TJ71PL/Precision-Clock/electronics/3d/HDC1080DMBR.STEP

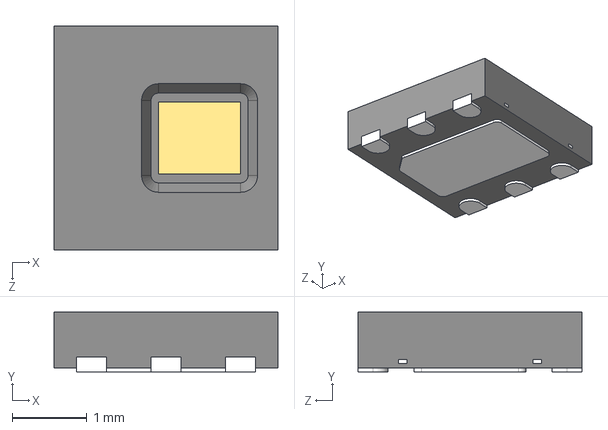
[picture p1: CAD file, 2026-03-11]
electronics/3d/HDC1080DMBR.STEP
3.00 x 0.8 x 3.00 mm
