TJ71PL/Precision-Clock/electronics/3d/WSON-8(8mm x 6mm).step

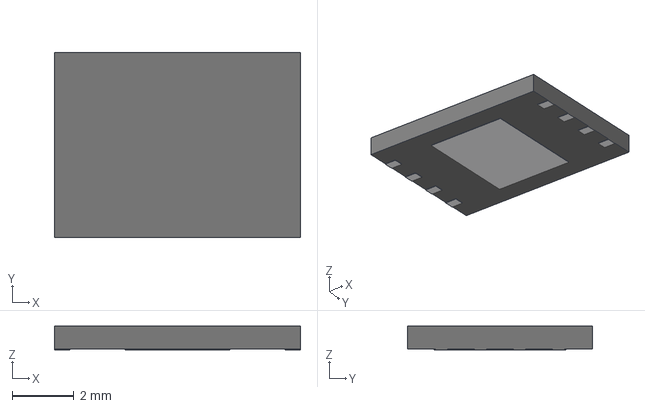
[picture p2: CAD file, 2026-03-08]
electronics/3d/WSON-8(8mm x 6mm).step
8.00 x 6.00 x 0.77 mm
