TJ71PL/Precision-Clock/electronics/3d/SA15-11SURKWA.stp

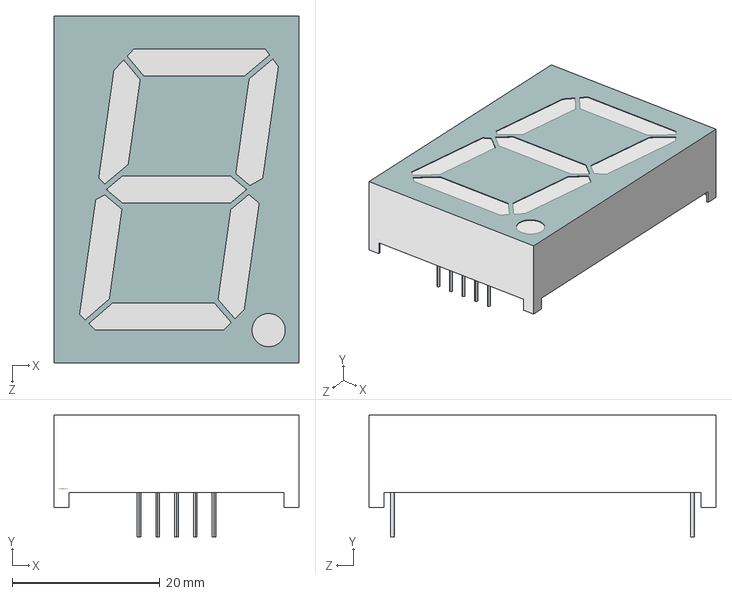
[picture p3: CAD file, 2026-03-08]
electronics/3d/SA15-11SURKWA.stp
33.2 x 16.5 x 47.0 mm
