TJ71PL/Precision-Clock/electronics/3d/PEC09-2320F-T0015.step

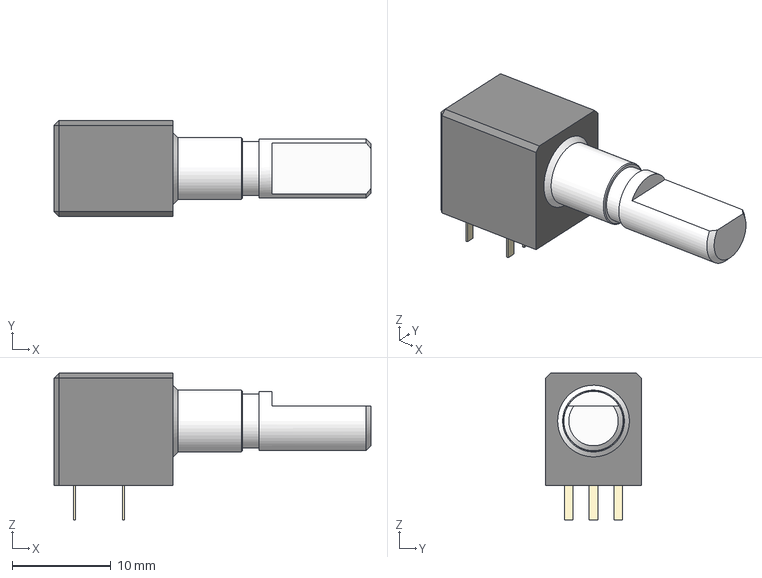
[picture p4: CAD file, 2026-02-25]
electronics/3d/PEC09-2320F-T0015.step
32.0 x 9.70 x 14.8 mm
