TJ71PL/Precision-Clock/electronics/3d/ST0201.step

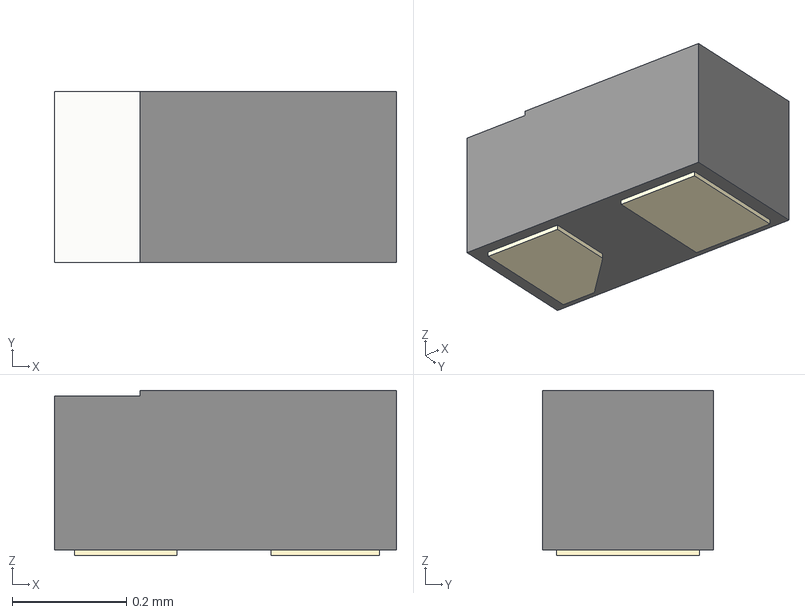
[picture p5: CAD file, 2026-02-25]
electronics/3d/ST0201.step
0.6 x 0.3 x 0.29 mm
