TJ71PL/Precision-Clock/electronics/3d/PinHeader_2x07_P1.27mm_Vertical_SMD.step

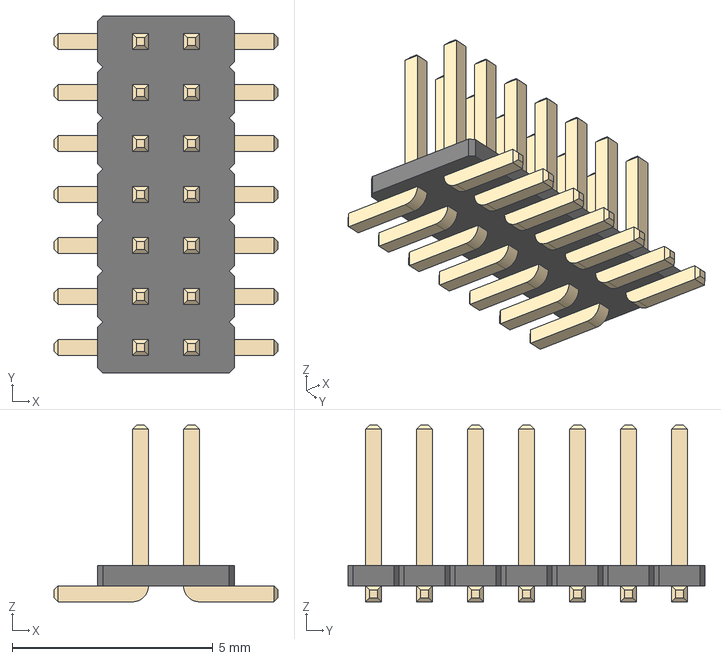
[picture p6: CAD file, 2026-02-24]
electronics/3d/PinHeader_2x07_P1.27mm_Vertical_SMD.step
5.57 x 8.89 x 4.40 mm
