TJ71PL/Precision-Clock/electronics/3d/SMA_Molex_73251-1153_EdgeMount_Horizontal.step

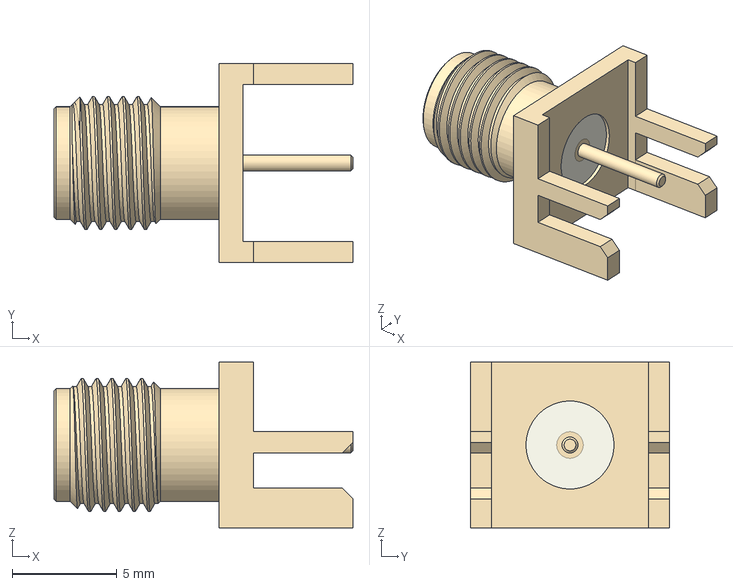
[picture p7: CAD file, 2026-02-24]
electronics/3d/SMA_Molex_73251-1153_EdgeMount_Horizontal.step
14.3 x 9.52 x 7.92 mm
