TJ71PL/Precision-Clock/electronics/3d/TEPT5700.STEP

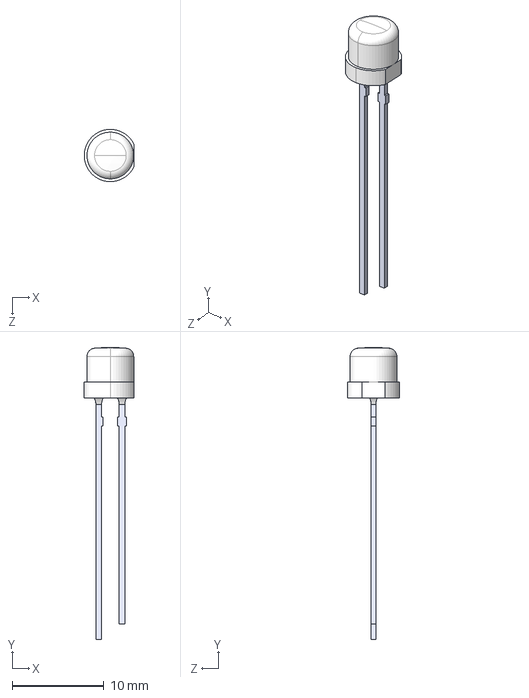
[picture p8: CAD file, 2026-02-24]
electronics/3d/TEPT5700.STEP
5.40 x 31.9 x 5.70 mm
