TJ71PL/Precision-Clock/electronics/3d/PWP0024B.stp

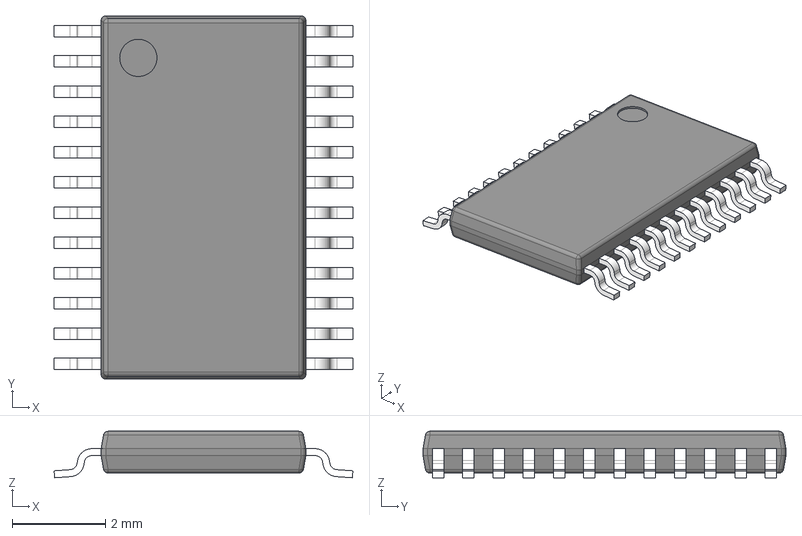
[picture p9: CAD file, 2026-02-09]
electronics/3d/PWP0024B.stp
6.42 x 7.80 x 1.00 mm
BODY-SO
LEAD-SO x 24
THERMALPAD-SO
PIN1-ID
