TJ71PL/Precision-Clock/electronics/3d/MC-146.stp

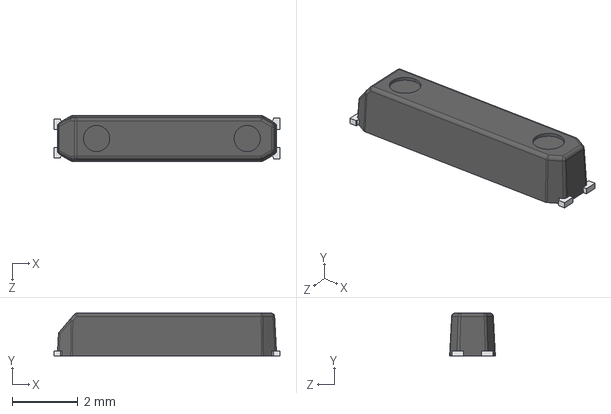
[picture p10: CAD file, 2026-02-09]
electronics/3d/MC-146.stp
6.90 x 1.30 x 1.40 mm
