TJ71PL/Precision-Clock/electronics/3d/PS1740P02CE.stp

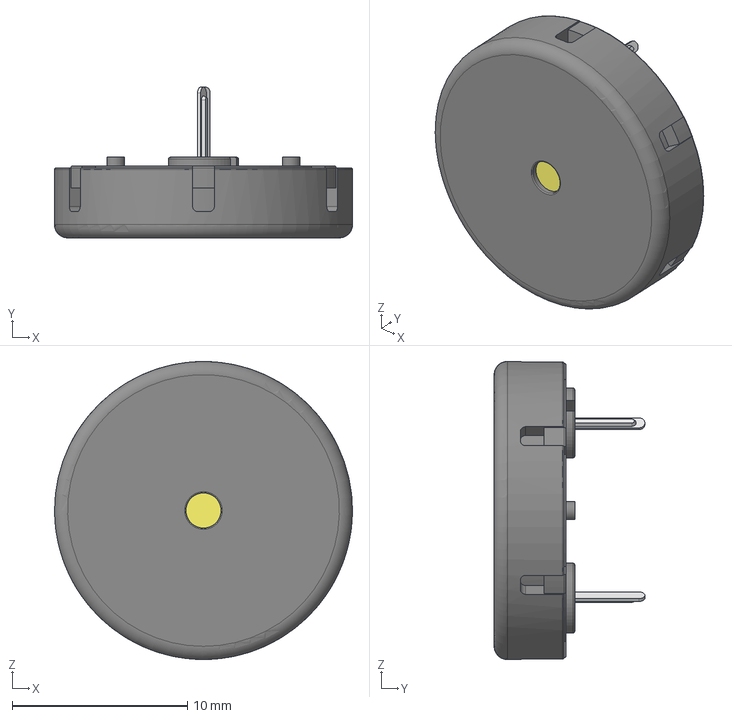
[picture p11: CAD file, 2026-01-29]
electronics/3d/PS1740P02CE.stp
17.0 x 8.60 x 17.0 mm
