TJ71PL/Precision-Clock/electronics/3d/SSSS811101.STEP

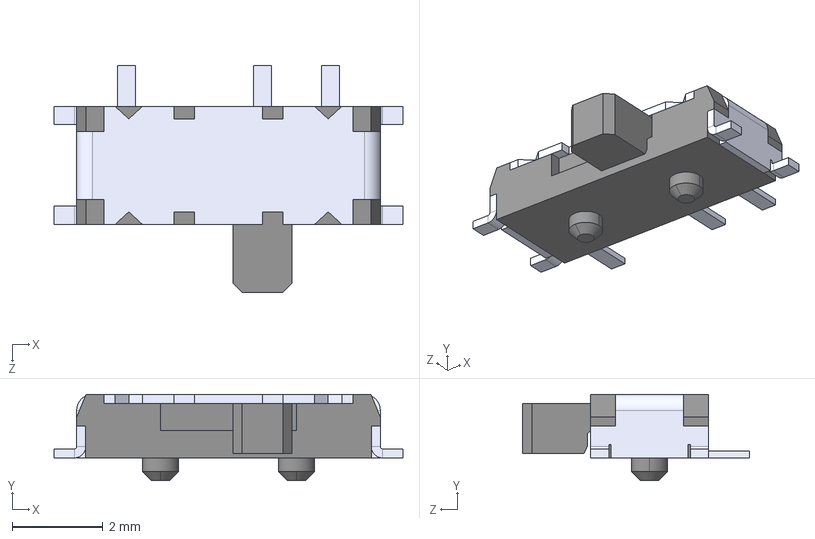
[picture p12: CAD file, 2026-01-27]
electronics/3d/SSSS811101.STEP
7.70 x 1.90 x 5.00 mm
