TJ71PL/Precision-Clock/electronics/3d/1060.STEP

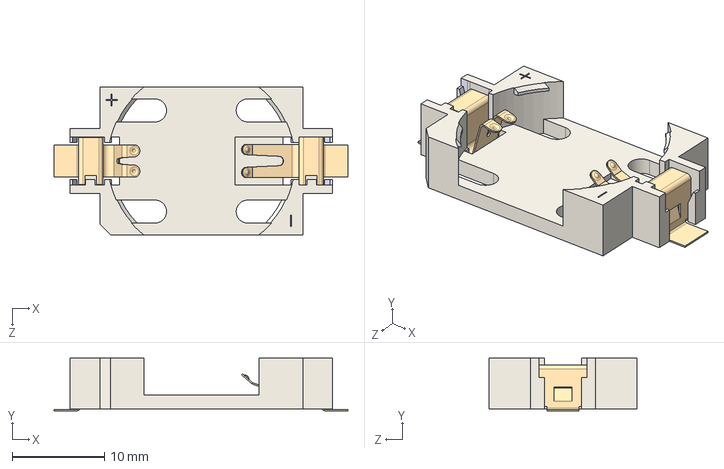
[picture p13: CAD file, 2025-11-13]
electronics/3d/1060.STEP
31.8 x 5.69 x 16.0 mm
