TJ71PL/Precision-Clock/electronics/3d/MAX-M10S-00B.STEP

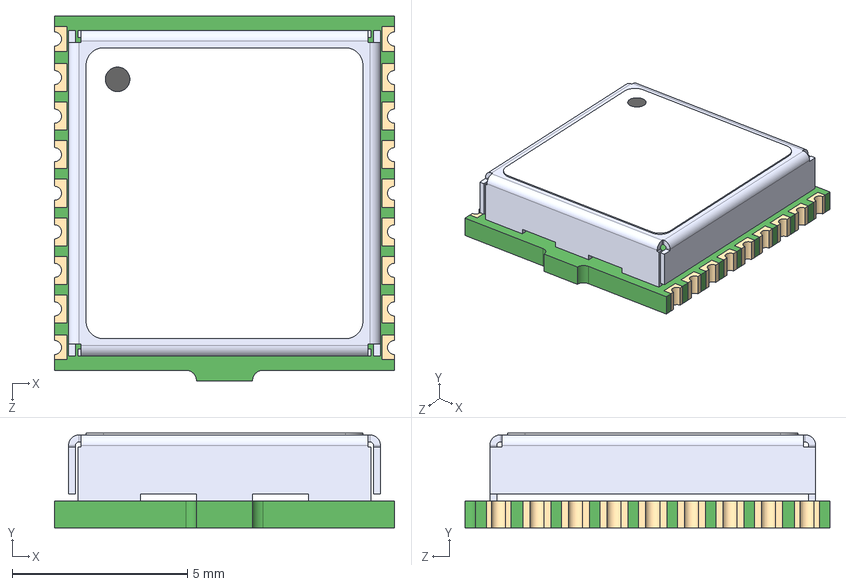
[picture p14: CAD file, 2025-10-22]
electronics/3d/MAX-M10S-00B.STEP
9.70 x 2.70 x 10.4 mm
