TJ71PL/Precision-Clock/electronics/3d/AP33771C.stp

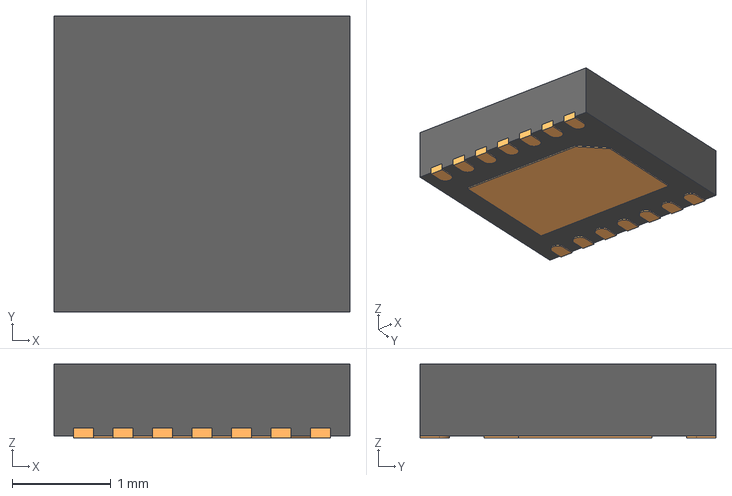
[picture p15: CAD file, 2026-02-24]
electronics/3d/AP33771C.stp
3.00 x 3.00 x 0.75 mm
