TJ71PL/Precision-Clock/electronics/3d/1054500101.stp

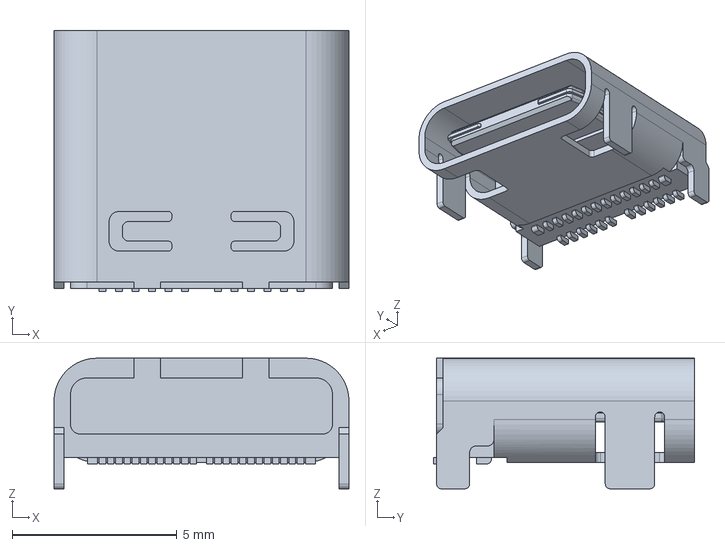
[picture p16: CAD file, 2025-11-11]
electronics/3d/1054500101.stp
8.94 x 7.90 x 3.96 mm
