TJ71PL/Precision-Clock/electronics/Schematic.pdf

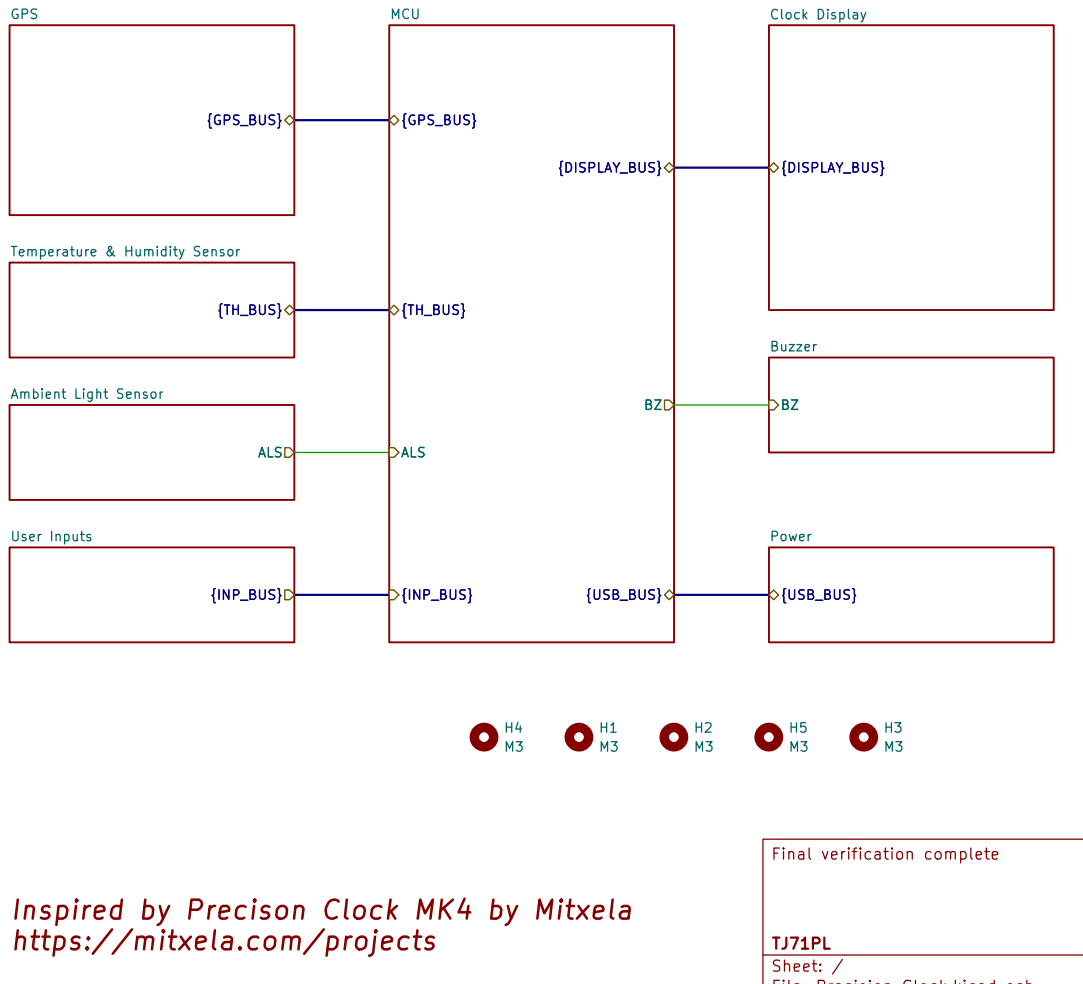
[picture p17: page 1]

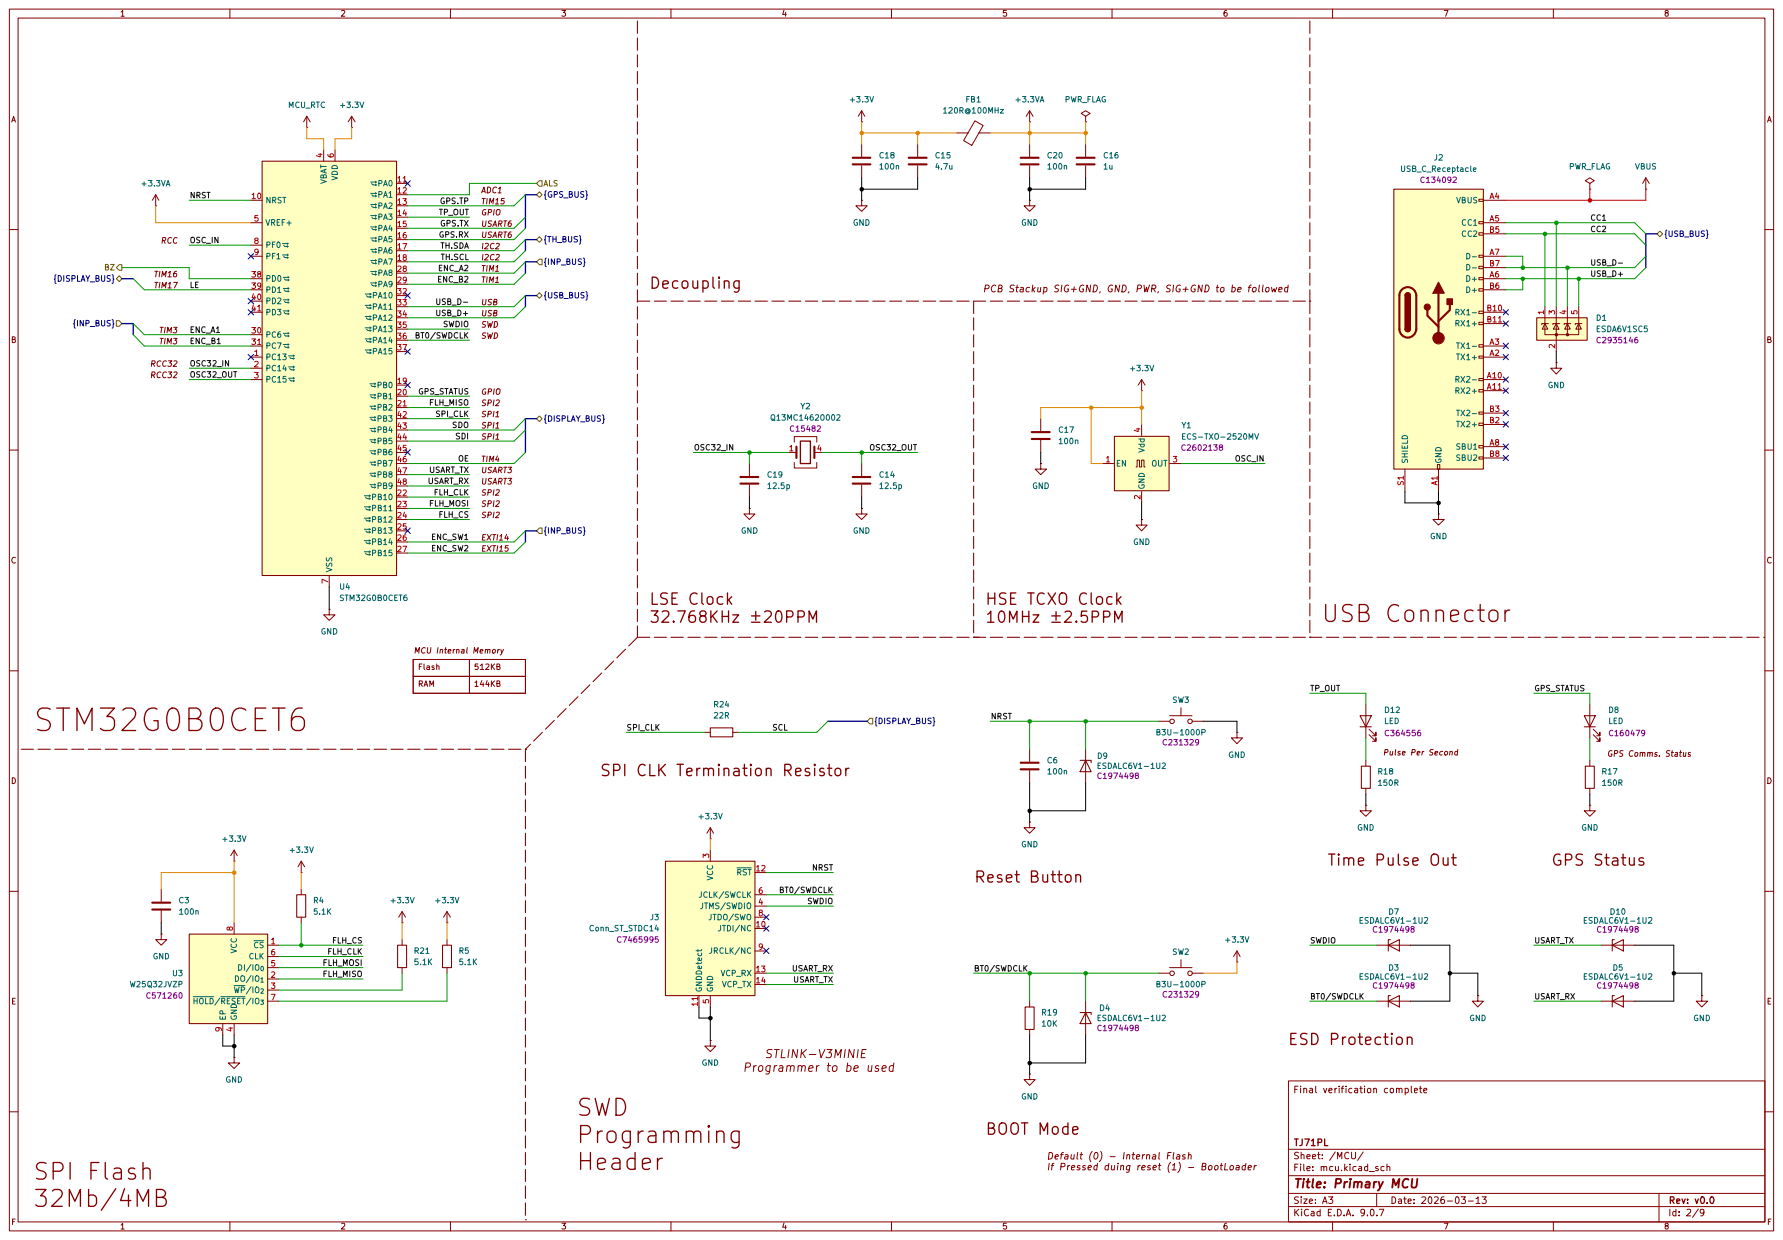
[picture p18: page 2]

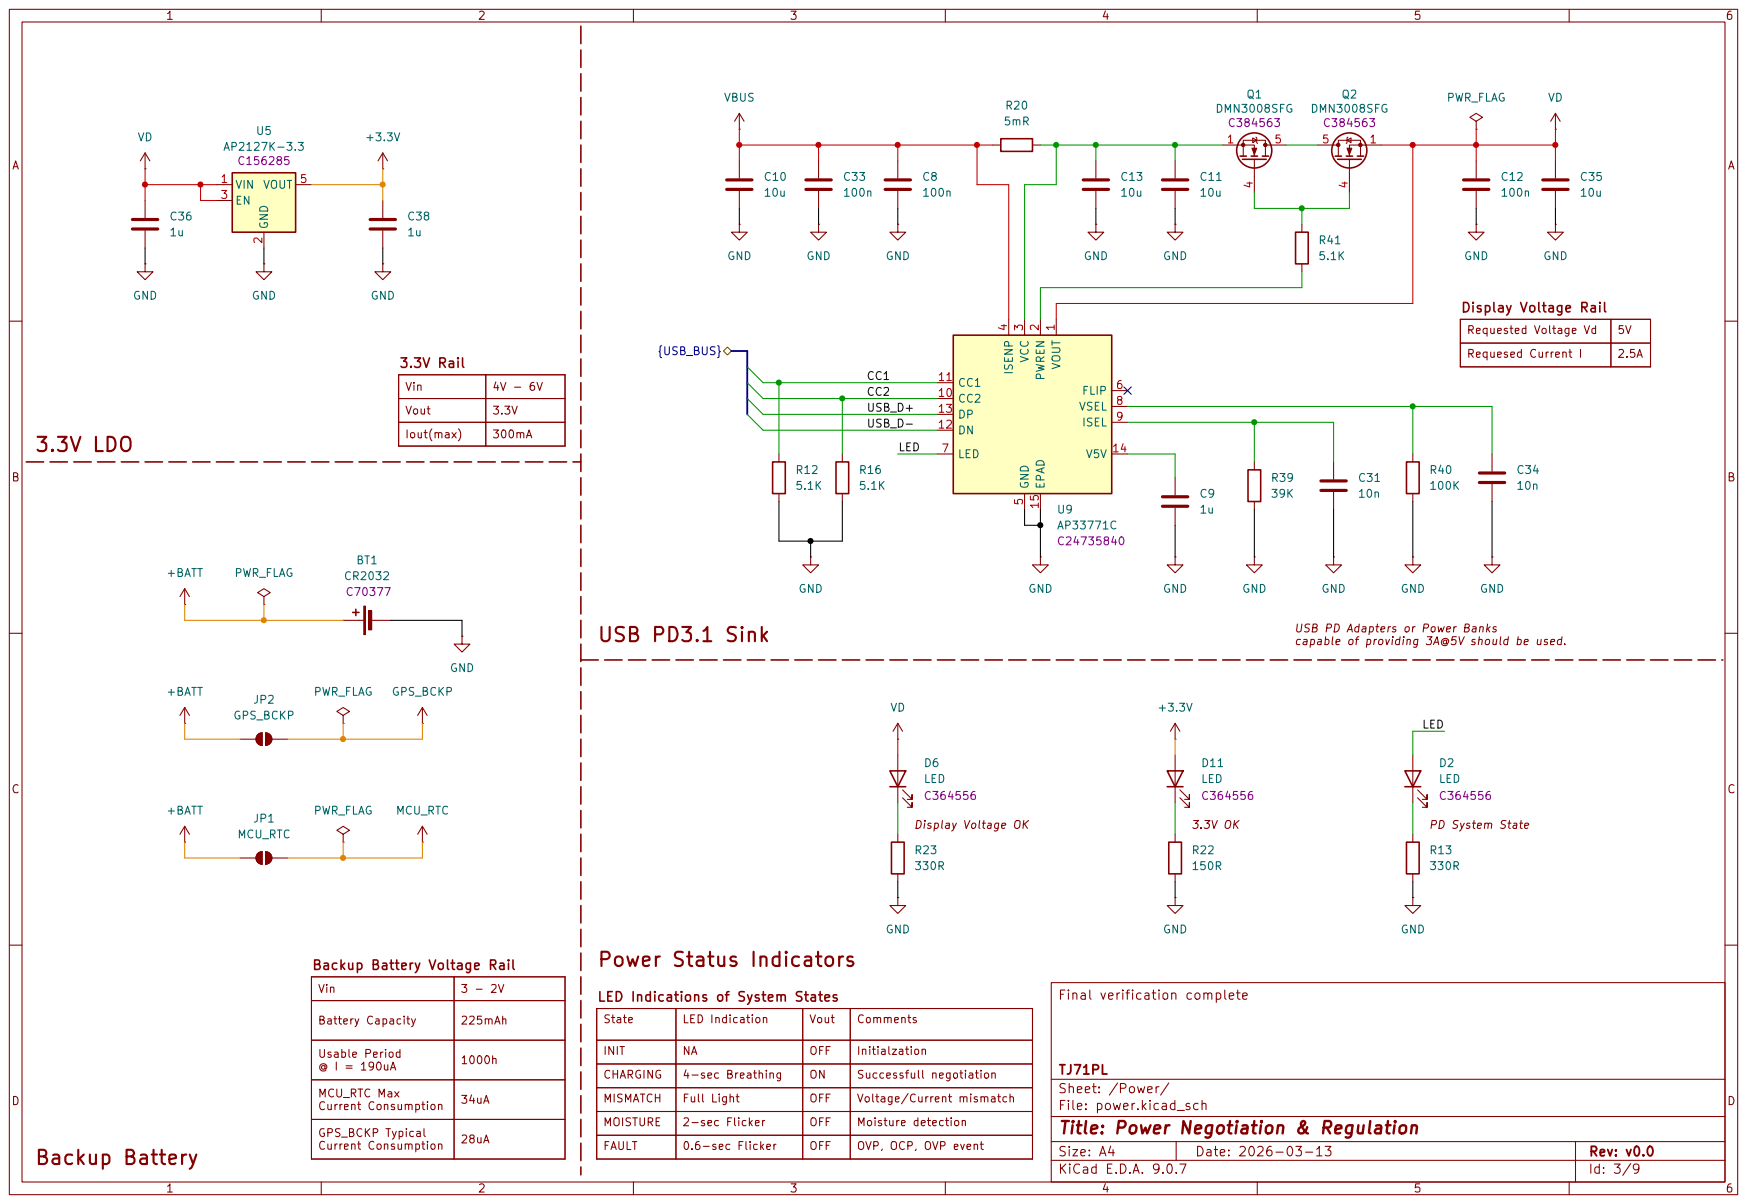
[picture p19: page 3]

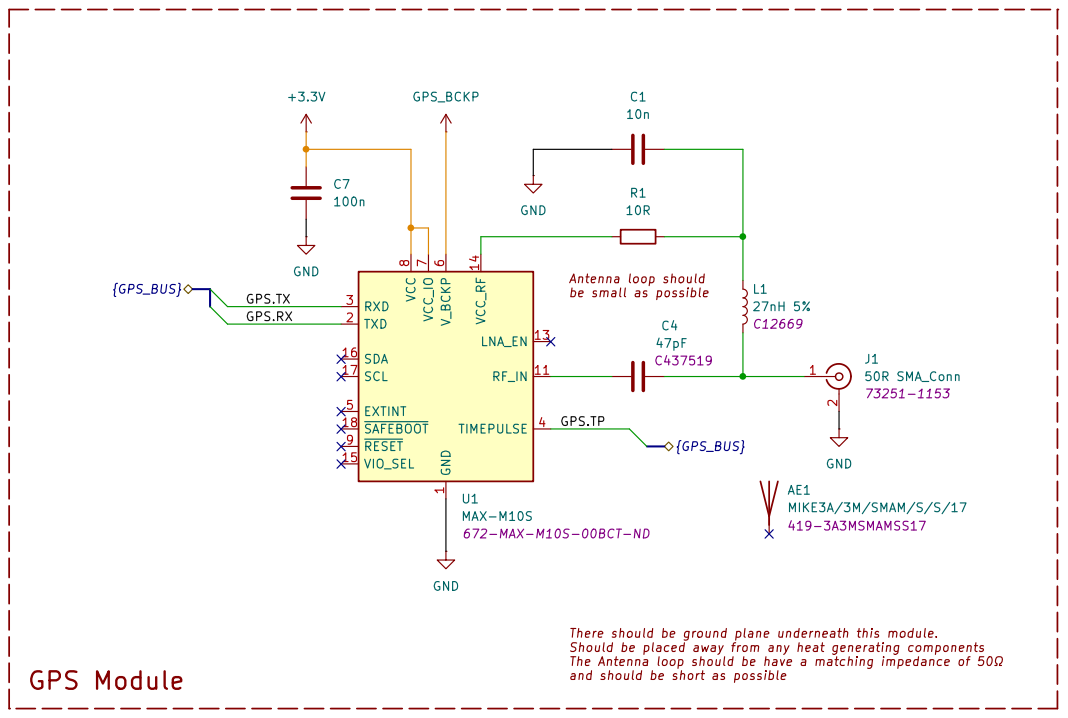
[picture p20: page 4]

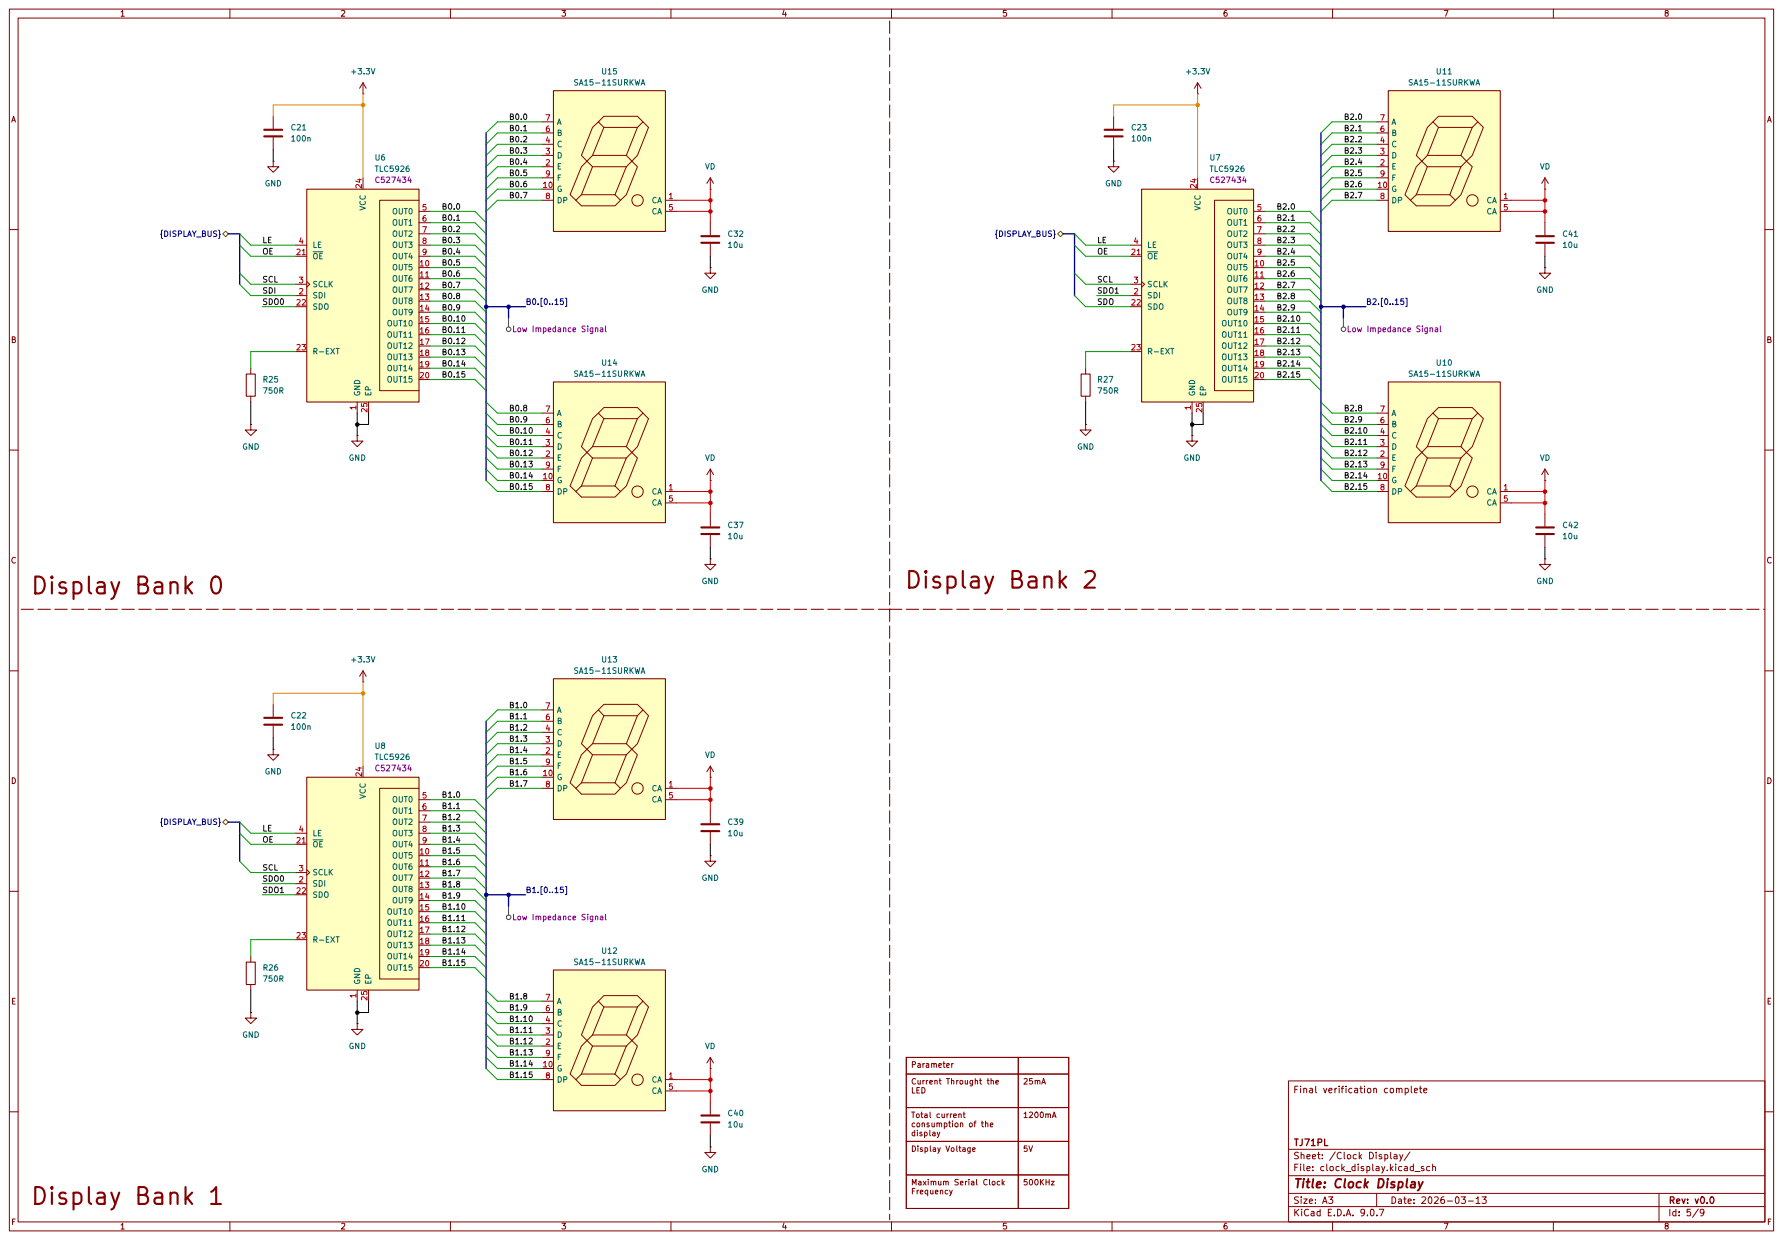
[picture p21: page 5]

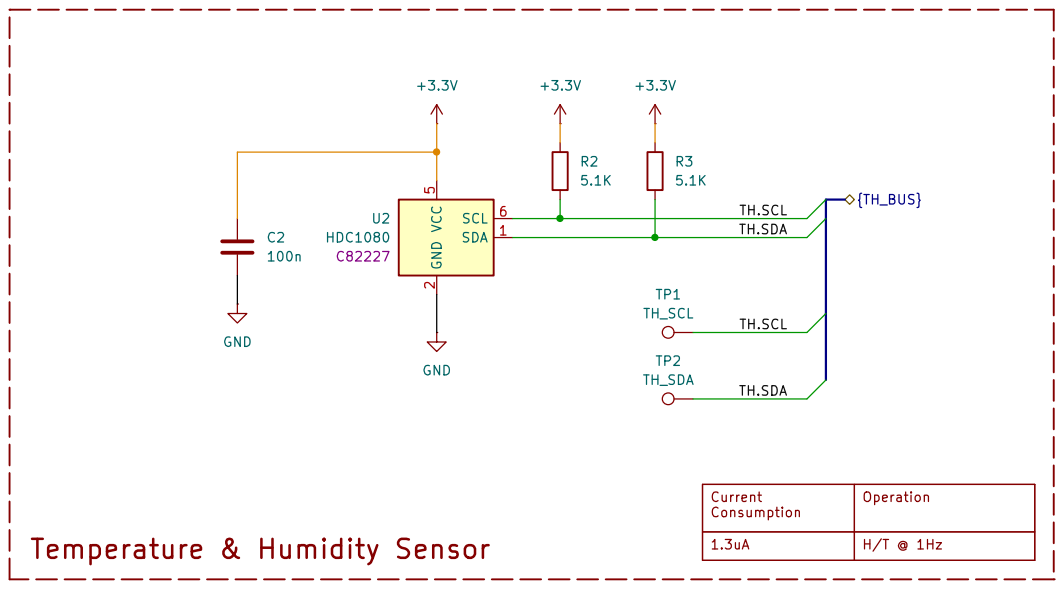
[picture p22: page 6]

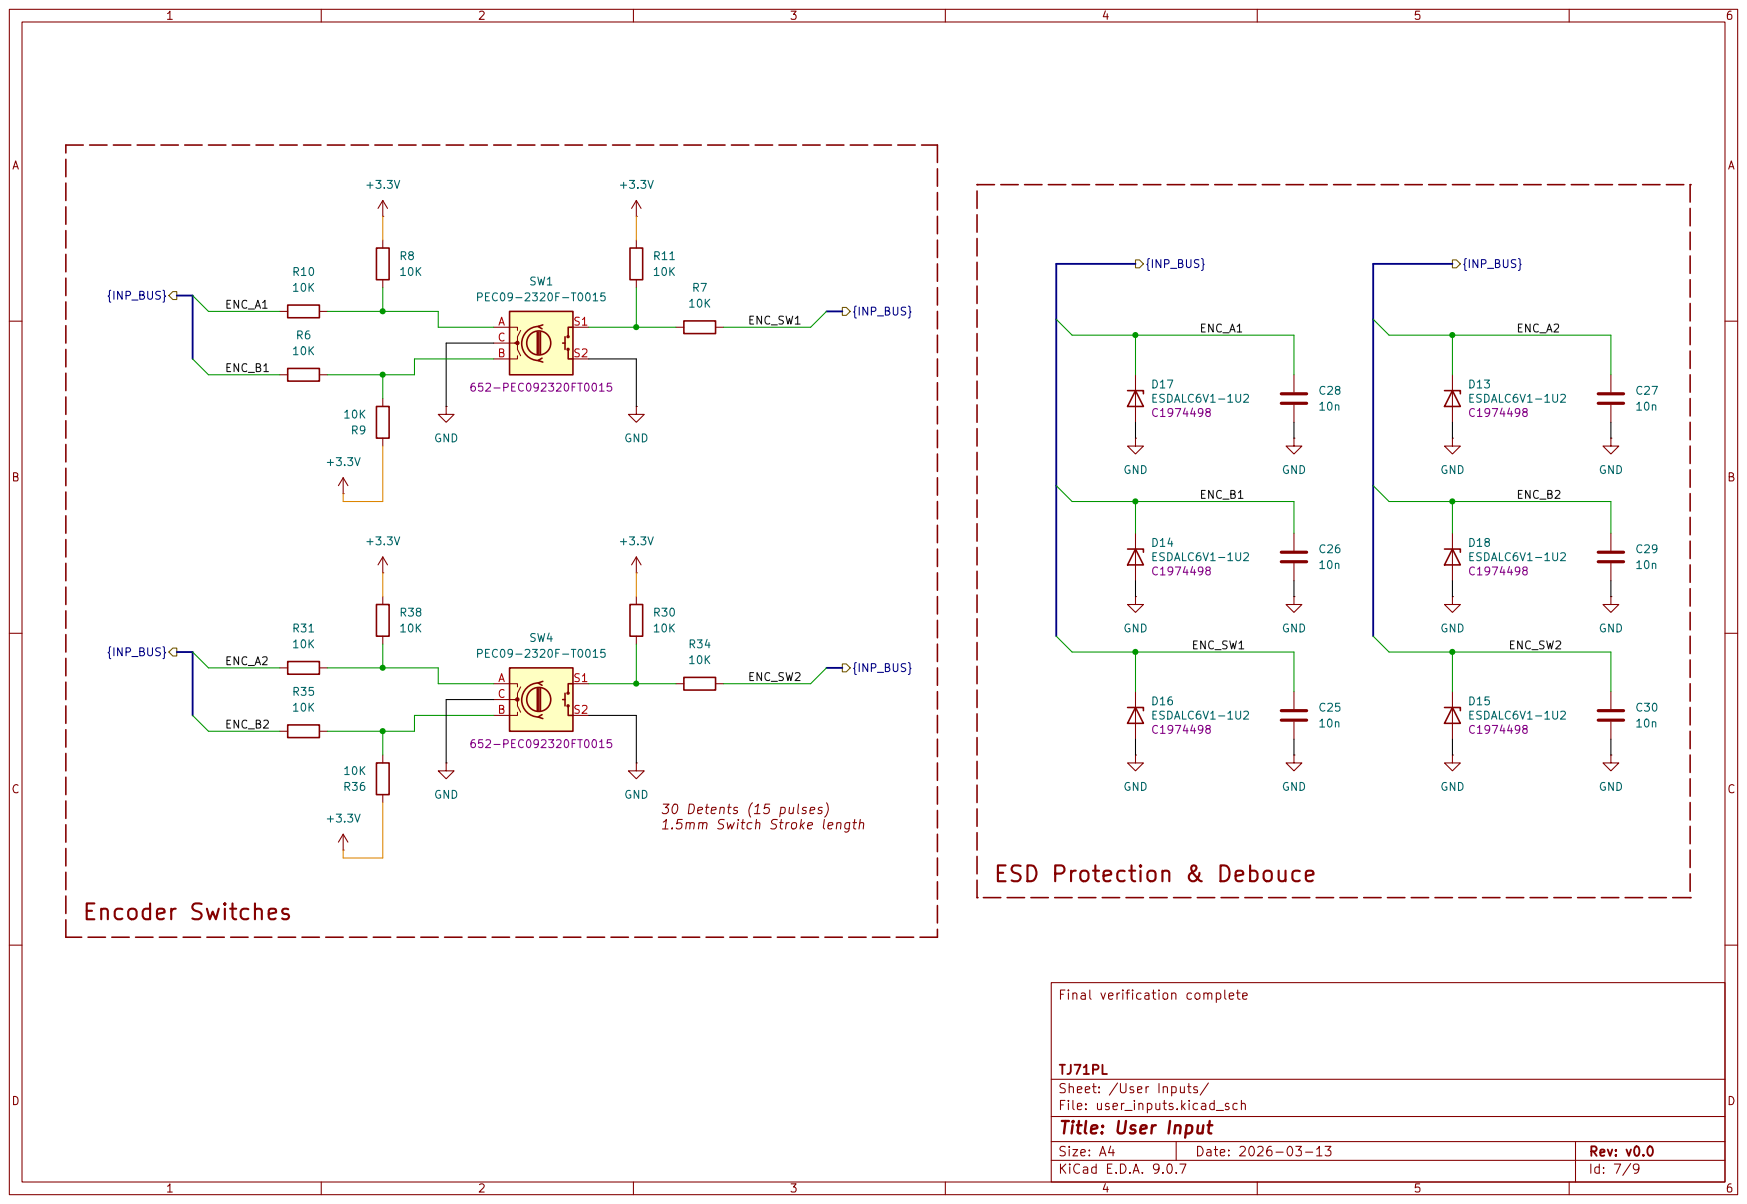
[picture p23: page 7]

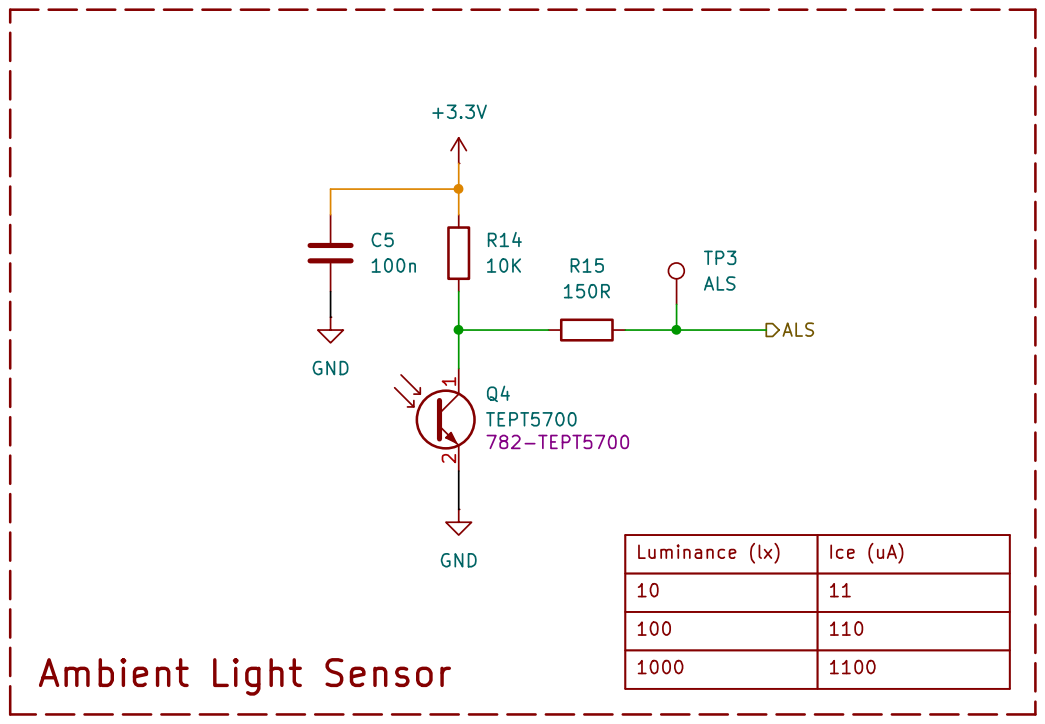
[picture p24: page 8]

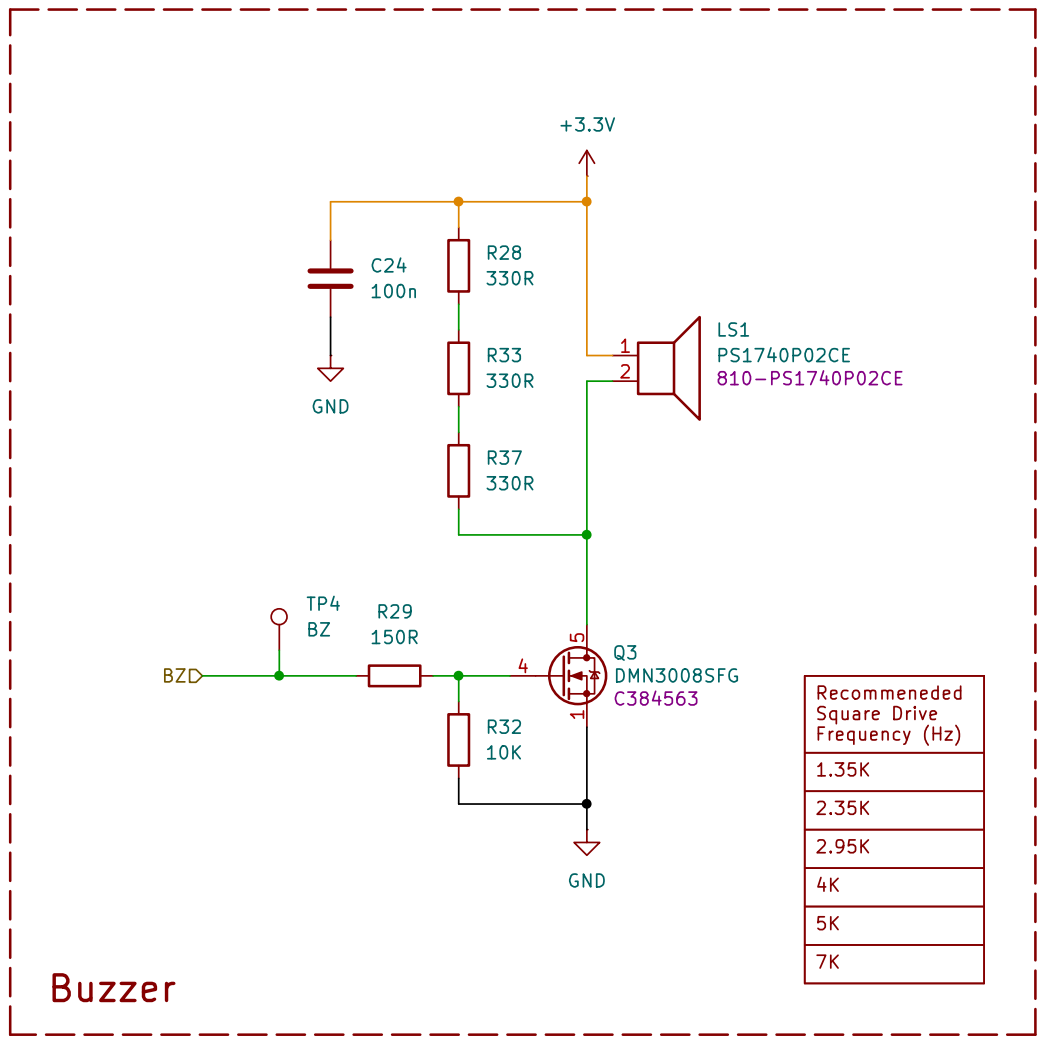
[picture p25: page 9]
