TJ71PL/Precision-Clock/electronics/Precision Clock.kicad_pcb

## KiCad design electronics/Precision Clock.kicad_pcb (2026-06-09)

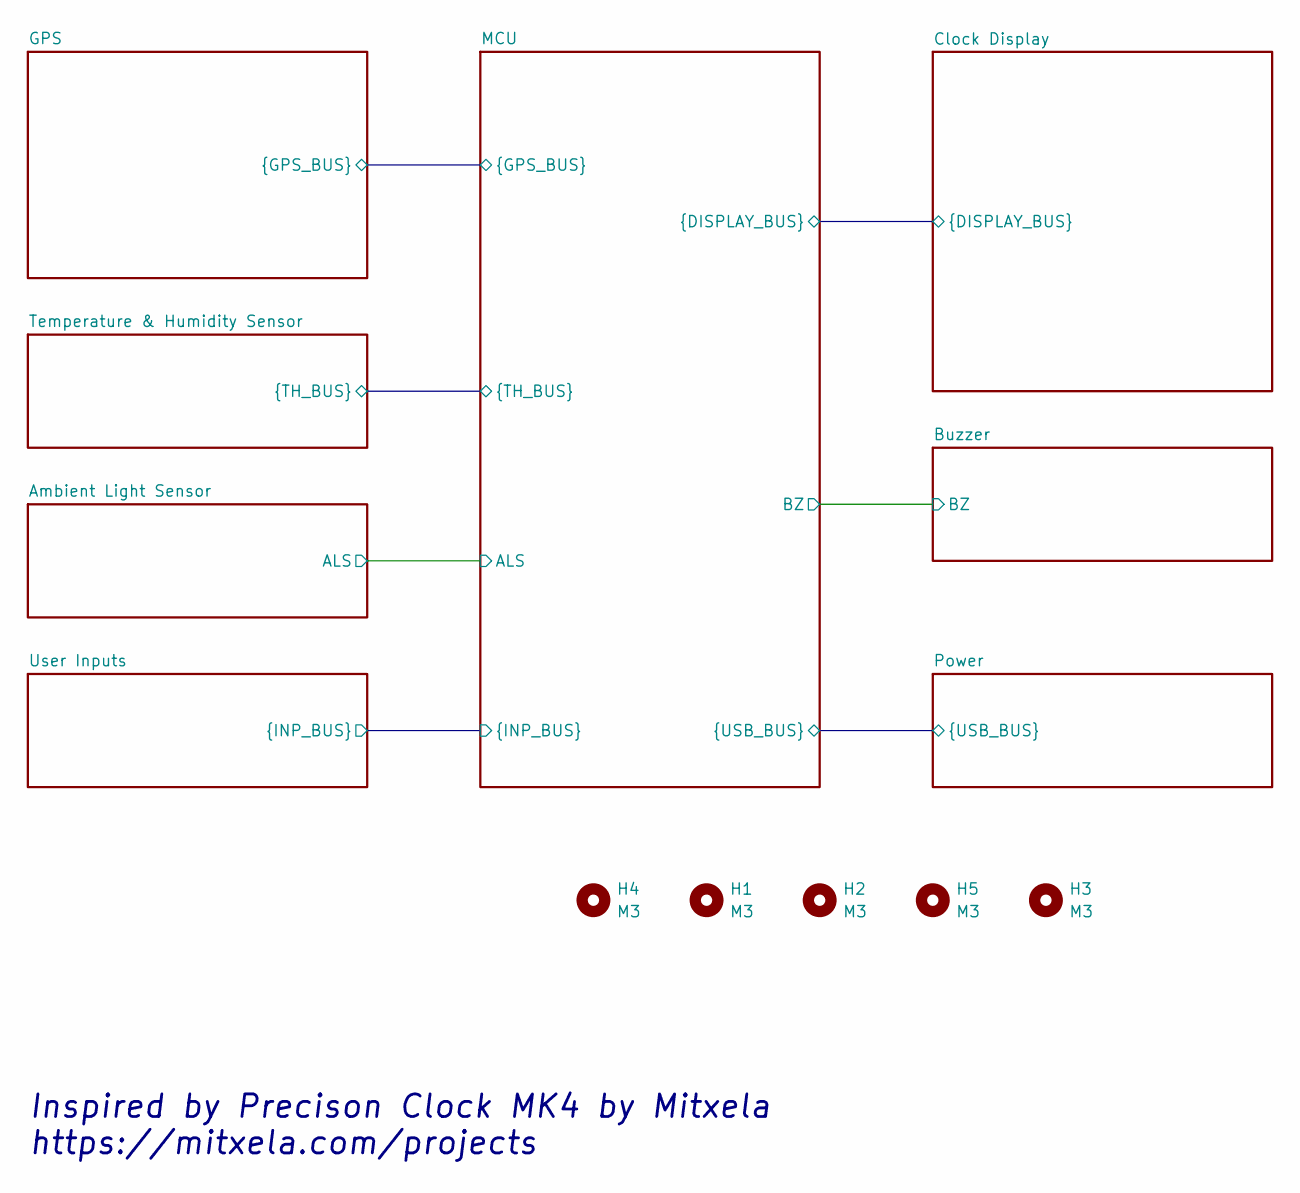
[picture p35: schematic Precision Clock.kicad_sch, Precision Clock]

Parts:
H1, H2, H3, H4, H5: M3; MountingHole_3.2mm_M3

Notes on the sheet:
Inspired by Precison Clock MK4 by Mitxela https://mitxela.com/projects

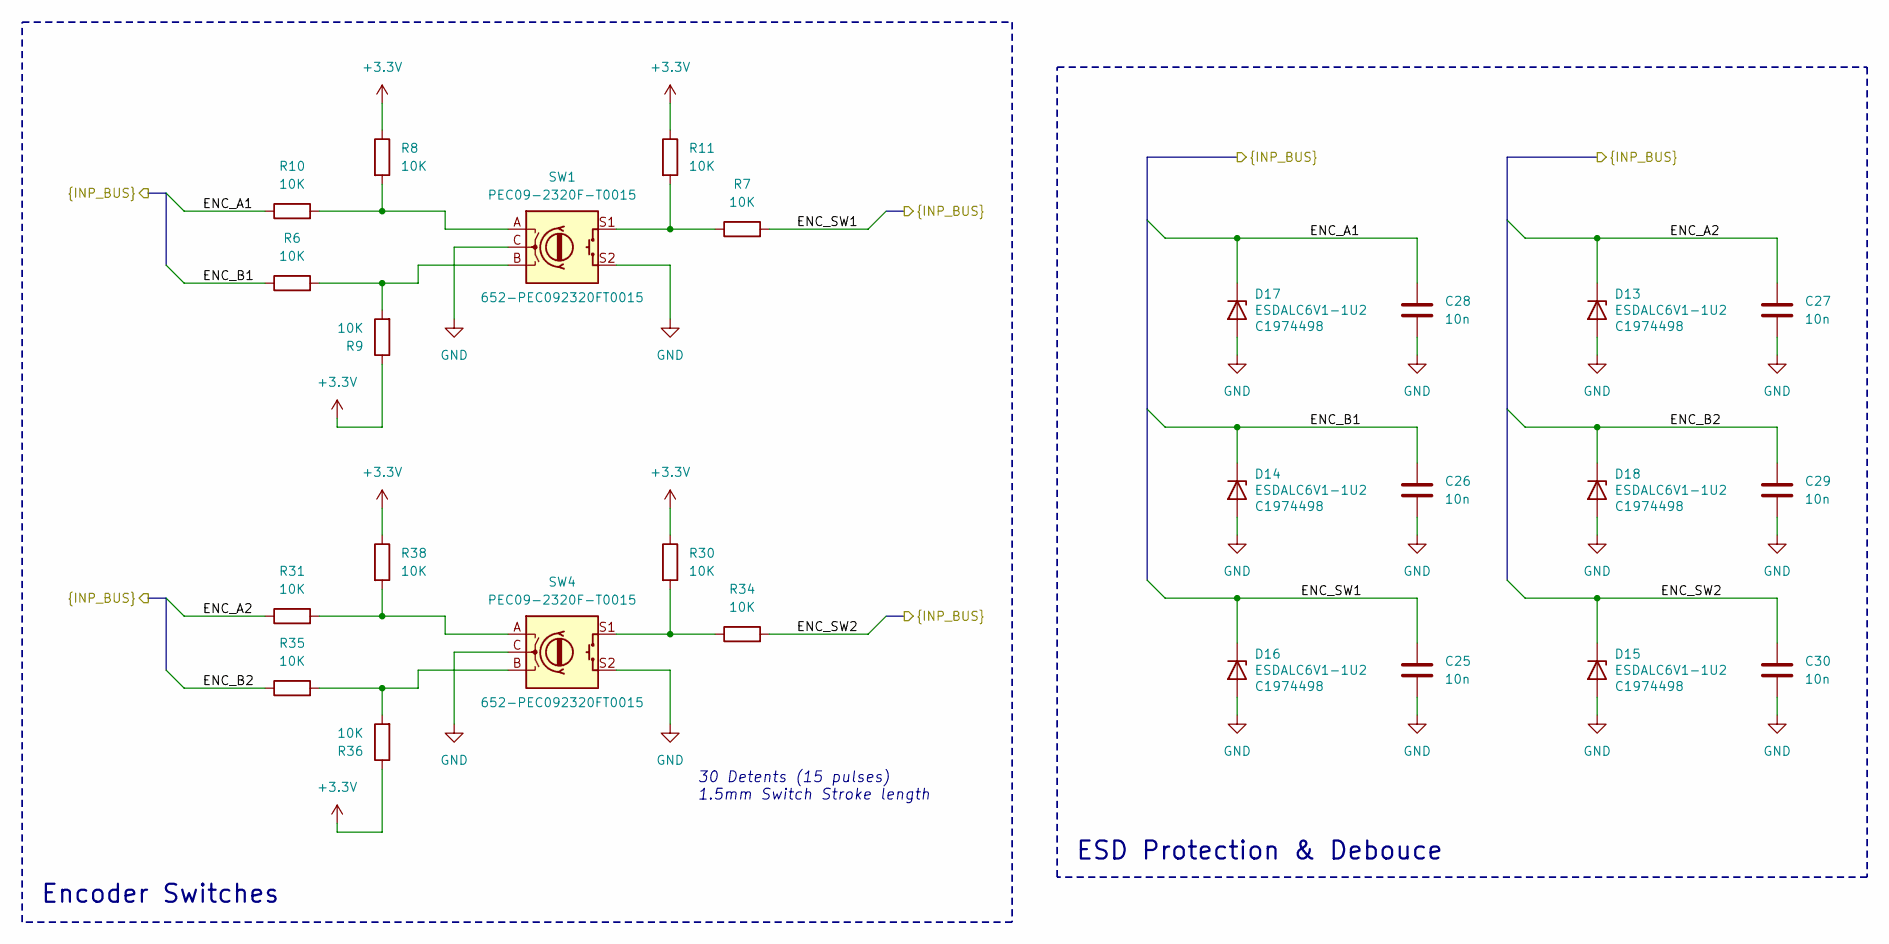
[picture p36: schematic user_inputs.kicad_sch, User Input]

Parts:
C25, C26, C27, C28, C29, C30: 10n; C_0402_1005Metric; LCSC C15195
D13, D14, D15, D16, D17, D18: ESDALC6V1-1U2; ST ESDALC6V1-1U2; LCSC C1974498
R6, R7, R8, R9, R10, R11, R30, R31, R34, R35, R36, R38: 10K; R_0402_1005Metric; LCSC C60489
SW1, SW4: PEC09-2320F-T0015; RotaryEncoder_Bourns_Horizontal_PEC09-2xxxF-Txxxx; Mouser 652-PEC092320FT0015

Connections:
+3.3V: R8.1, R9.1, R11.1, R30.1, R36.1, R38.1; also elsewhere on the board
/MCU/ENC_A1: C28.1, D17.1 (K), R10.1; also elsewhere on the board
/MCU/ENC_A2: C27.1, D13.1 (K), R31.1; also elsewhere on the board
/MCU/ENC_B1: C26.1, D14.1 (K), R6.1; also elsewhere on the board
/MCU/ENC_B2: C29.1, D18.1 (K), R35.1; also elsewhere on the board
/MCU/ENC_SW1: C25.1, D16.1 (K), R7.2; also elsewhere on the board
/MCU/ENC_SW2: C30.1, D15.1 (K), R34.2; also elsewhere on the board
GND: C25.2, C26.2, C27.2, C28.2, C29.2, C30.2, D13.2 (A), D14.2 (A), D15.2 (A), D16.2 (A), D17.2 (A), D18.2 (A), SW1.C, SW1.S2, SW4.C, SW4.S2; also elsewhere on the board
unnamed: R6.2, R9.2, SW1.B
unnamed: R8.2, R10.2, SW1.A
unnamed: R7.1, R11.2, SW1.S1
unnamed: R30.2, R34.1, SW4.S1
unnamed: R31.2, R38.2, SW4.A
unnamed: R35.2, R36.2, SW4.B

Notes on the sheet:
Encoder Switches
ESD Protection & Debouce
30 Detents (15 pulses) 1.5mm Switch Stroke length

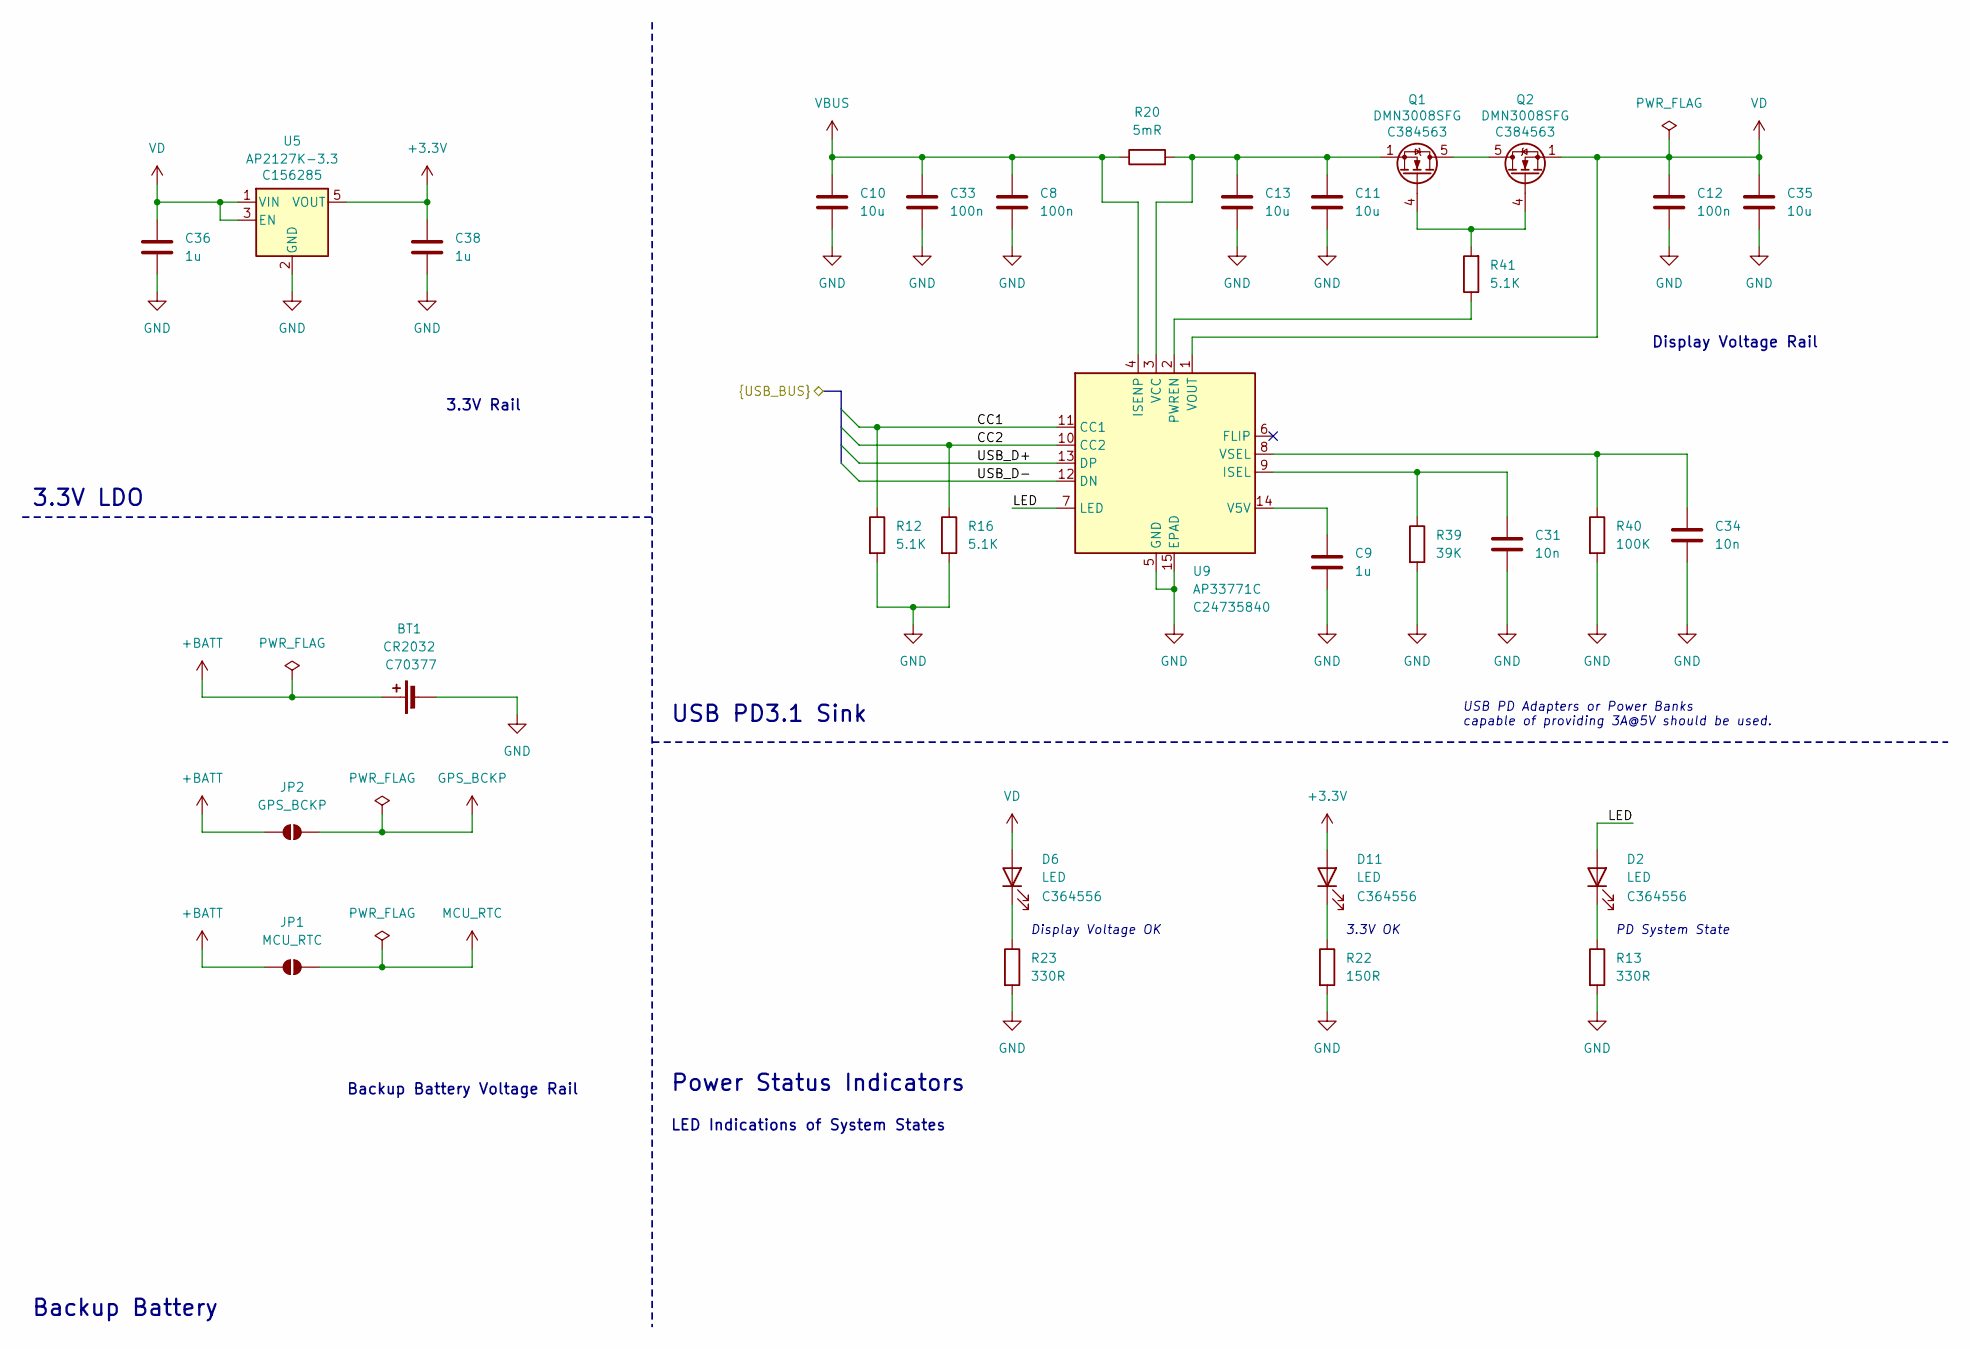
[picture p37: schematic power.kicad_sch, Power Negotiation & Regulation]

Parts:
BT1: CR2032; Battery_holder_CR2032_SMD; LCSC C70377
C8, C12, C33: 100n; C_0402_1005Metric; LCSC C1525
C9, C36, C38: 1u; C_0402_1005Metric; LCSC C29266
C10, C11, C13, C35: 10u; C_0603_1608Metric; LCSC C86275
C31, C34: 10n; C_0402_1005Metric; LCSC C15195
D2, D6, D11: LED; LED_LiteON_LTST-C281KGKT; LCSC C364556
JP1: MCU_RTC; SolderJumper-2_P1.3mm_Open_TrianglePad1.0x1.5mm
JP2: GPS_BCKP; SolderJumper-2_P1.3mm_Open_TrianglePad1.0x1.5mm
Q1, Q2: DMN3008SFG; Diodes_PowerDI3333-8; LCSC C384563
R12, R16, R41: 5.1K; R_0402_1005Metric; LCSC C105872
R13, R23: 330R; R_0402_1005Metric; LCSC C276273
R20: 5mR; R_0805_2012Metric; LCSC C92742
R22: 150R; R_0402_1005Metric; LCSC C276273
R39: 39K; R_0402_1005Metric; LCSC C137995
R40: 100K; R_0402_1005Metric; LCSC C60491
U5: AP2127K-3.3; SOT-23-5; LCSC C156285
U9: AP33771C; W-DFN3030-14 (Type A1) Diodes; LCSC C24735840

Connections:
+3.3V: C38.1, D11.2 (A), U5.5 (VOUT); also elsewhere on the board
+BATT: BT1.1 (+), JP1.1 (A), JP2.1 (A)
/MCU/CC1: R12.1, U9.11 (CC1); also elsewhere on the board
/MCU/CC2: R16.1, U9.10 (CC2); also elsewhere on the board
/MCU/USB_D+: U9.13 (DP); also elsewhere on the board
/MCU/USB_D-: U9.12 (DN); also elsewhere on the board
/Power/LED: D2.2 (A), U9.7 (LED)
GND: BT1.2 (-), C8.2, C9.2, C10.2, C11.2, C12.2, C13.2, C31.2, C33.2, C34.2, C35.2, C36.2, C38.2, R12.2, R13.2, R16.2, R22.2, R23.2, R39.2, R40.2, U5.2 (GND), U9.5 (GND), U9.15 (EPAD); also elsewhere on the board
GPS_BCKP: JP2.2 (B); also elsewhere on the board
MCU_RTC: JP1.2 (B); also elsewhere on the board
unnamed: D2.1 (K), R13.1
unnamed: D6.1 (K), R23.1
unnamed: D11.1 (K), R22.1
unnamed: Q1.5 (D), Q2.5 (D)
unnamed: Q1.4 (G), Q2.4 (G), R41.2
unnamed: C31.1, R39.1, U9.9 (ISEL)
unnamed: R41.1, U9.2 (PWREN)
unnamed: C9.1, U9.14 (V5V)
unnamed: C11.1, C13.1, Q1.1 (S), Q1.2 (S), Q1.3 (S), R20.2, U9.3 (VCC)
unnamed: C34.1, R40.1, U9.8 (VSEL)
VBUS: C8.1, C10.1, C33.1, R20.1, U9.4 (ISENP); also elsewhere on the board
VD: C12.1, C35.1, C36.1, D6.2 (A), Q2.1 (S), Q2.2 (S), Q2.3 (S), U5.1 (VIN), U5.3 (EN), U9.1 (VOUT); also elsewhere on the board

Notes on the sheet:
LED Indications of System States
Backup Battery
3.3V LDO
USB PD Adapters or Power Banks capable of providing 3A@5V should be used.
3.3V OK
PD System State
Display Voltage OK
Display Voltage Rail
3.3V Rail
Backup Battery Voltage Rail
Power Status Indicators
USB PD3.1 Sink

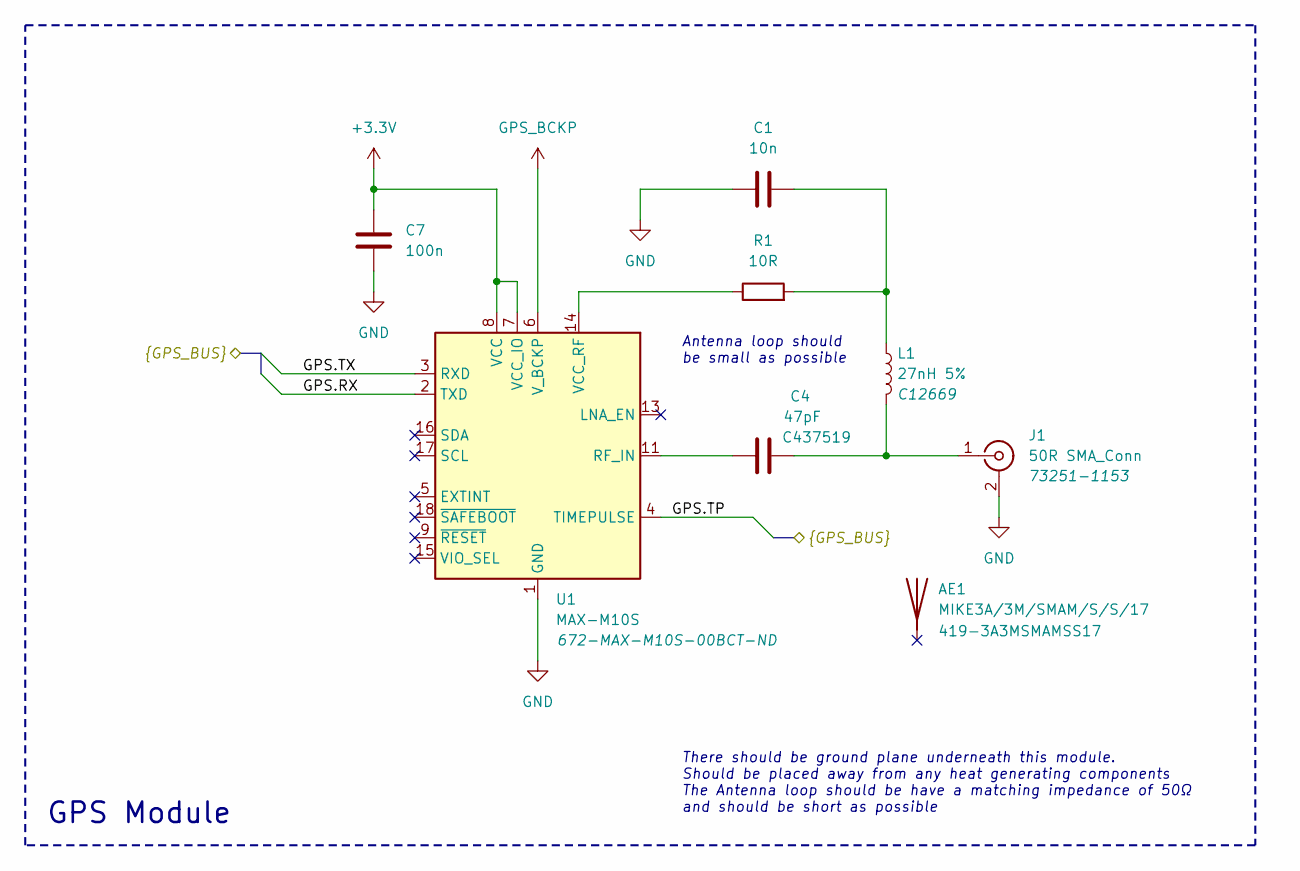
[picture p38: schematic gps.kicad_sch, GPS Module]

Parts:
AE1: MIKE3A/3M/SMAM/S/S/17; Mouser 419-3A3MSMAMSS17
C1: 10n; C_0402_1005Metric; LCSC C15195
C4: 47pF; C_0402_1005Metric; LCSC C437519
C7: 100n; C_0402_1005Metric; LCSC C1525
J1: 50R SMA_Conn; SMA_Molex_73251-1153_EdgeMount_Horizontal; Mouser 73251-1153
L1: 27nH 5%; L_0402_1005Metric; LCSC C12669
R1: 10R; R_0603_1608Metric; LCSC C109318
U1: MAX-M10S; ublox_MAX; Digikey 672-MAX-M10S-00BCT-ND

Connections:
+3.3V: C7.1, U1.7 (VCC_IO), U1.8 (VCC); also elsewhere on the board
/GPS/GPS.RX: U1.2 (TXD); also elsewhere on the board
/GPS/GPS.TP: U1.4 (TIMEPULSE); also elsewhere on the board
/GPS/GPS.TX: U1.3 (RXD); also elsewhere on the board
GND: C1.1, C7.2, J1.2 (Ext), U1.1 (GND), U1.10 (GND), U1.12 (GND); also elsewhere on the board
GPS_BCKP: U1.6 (V_BCKP); also elsewhere on the board
unnamed: C1.2, L1.1, R1.2
unnamed: C4.2, J1.1 (In), L1.2
unnamed: C4.1, U1.11 (RF_IN)
unnamed: R1.1, U1.14 (VCC_RF)

Notes on the sheet:
Antenna loop should be small as possible
GPS Module
There should be ground plane underneath this module. Should be placed away from any heat generating components The Antenna loop should be have a matching impedance of 50Ω and should be short as possible

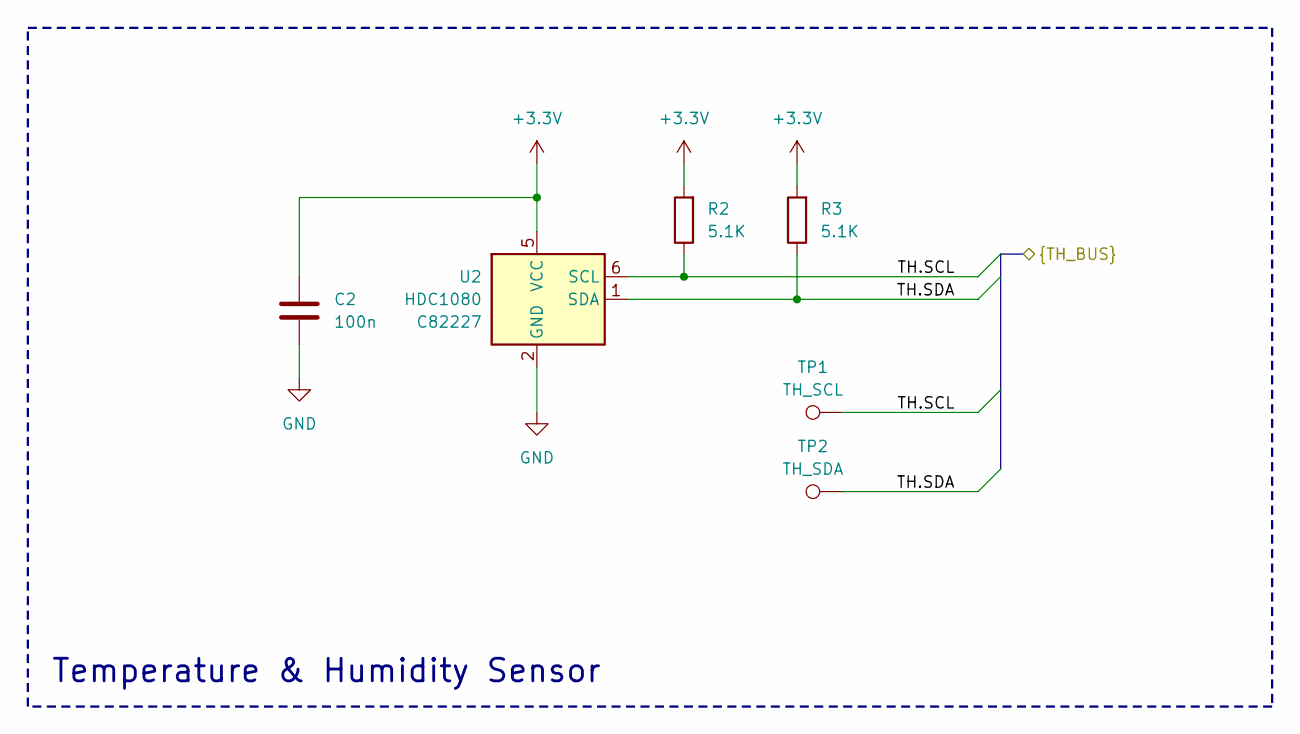
[picture p39: schematic temperature_humidity_sensor.kicad_sch, Temperature & Humidity Sensor]

Parts:
C2: 100n; C_0402_1005Metric; LCSC C1525
R2, R3: 5.1K; R_0402_1005Metric; LCSC C105872
TP1: TH_SCL; TestPoint_Pad_D1.0mm
TP2: TH_SDA; TestPoint_Pad_D1.0mm
U2: HDC1080; Texas_PWSON-N6; LCSC C82227

Connections:
+3.3V: C2.1, R2.2, R3.2, U2.5 (VCC); also elsewhere on the board
/MCU/TH.SCL: R2.1, TP1.1, U2.6 (SCL); also elsewhere on the board
/MCU/TH.SDA: R3.1, TP2.1, U2.1 (SDA); also elsewhere on the board
GND: C2.2, U2.2 (GND); also elsewhere on the board

Notes on the sheet:
Temperature & Humidity Sensor

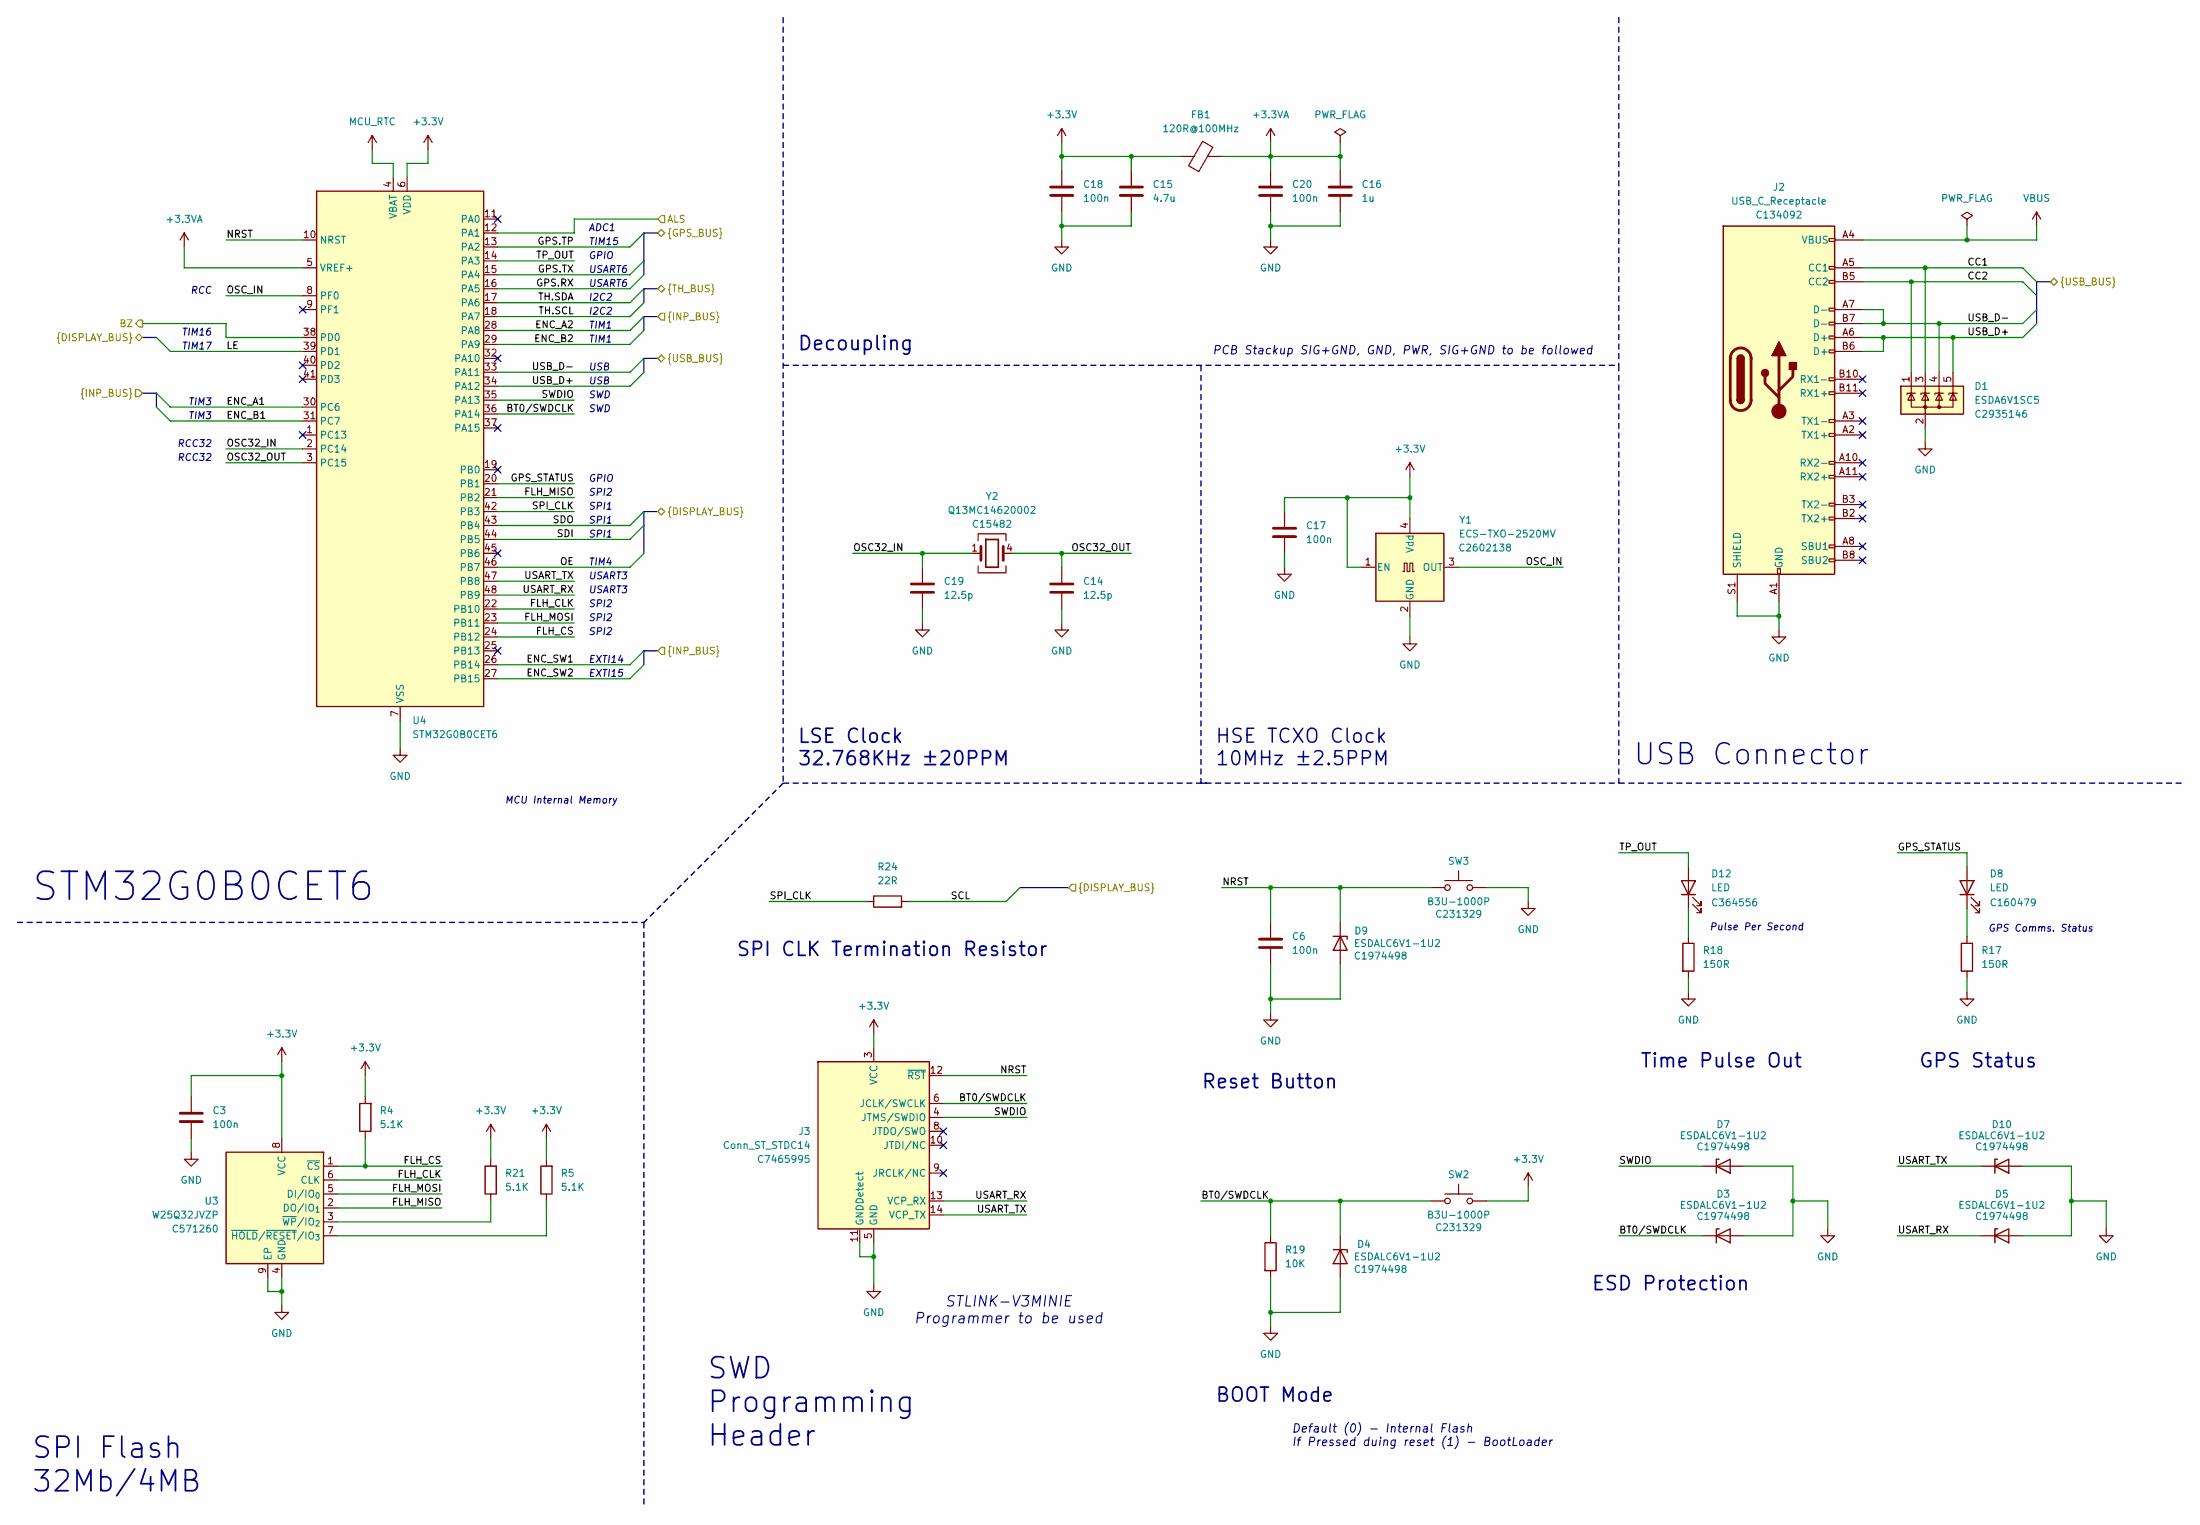
[picture p40: schematic mcu.kicad_sch, Primary MCU]

Parts:
C3, C6, C17, C18, C20: 100n; C_0402_1005Metric; LCSC C1525
C14, C19: 12.5p; C_0402_1005Metric; LCSC C26406
C15: 4.7u; C_0603_1608Metric; LCSC C69335
C16: 1u; C_0402_1005Metric; LCSC C29266
D1: ESDA6V1SC5; SOT-23-5; LCSC C2935146
D3, D4, D5, D7, D9, D10: ESDALC6V1-1U2; ST ESDALC6V1-1U2; LCSC C1974498
D8: LED; LED_LiteON_LTST-C281KGKT; LCSC C160479
D12: LED; LED_LiteON_LTST-C281KGKT; LCSC C364556
FB1: 120R@100MHz; R_0402_1005Metric; LCSC C38480
J2: USB_C_Receptacle; USB_C_Receptacle_Molex_105450-0101; LCSC C134092
J3: Conn_ST_STDC14; ST STDC14; LCSC C7465995
R4, R5, R21: 5.1K; R_0402_1005Metric; LCSC C105872
R17, R18: 150R; R_0402_1005Metric; LCSC C137936
R19: 10K; R_0402_1005Metric; LCSC C60489
R24: 22R; R_0402_1005Metric; LCSC C109318
SW2, SW3: B3U-1000P; SW_SPST_B3U-1000P; LCSC C231329
U3: W25Q32JVZP; WSON-8-1EP_6x5mm_P1.27mm_EP3.4x4.3mm; LCSC C571260
U4: STM32G0B0CET6; LQFP-48_7x7mm_P0.5mm; LCSC C2826978
Y1: ECS-TXO-2520MV; ECS_TXO-2520MV; LCSC C2602138
Y2: Q13MC14620002; Crystal_SMD_SeikoEpson_MC146-4Pin_6.7x1.5mm; LCSC C15482

Connections:
+3.3V: C3.1, C15.1, C17.1, C18.1, FB1.1, J3.3 (VCC), R4.2, R5.2, R21.2, SW2.2, U3.8 (VCC), U4.6 (VDD), Y1.1 (EN), Y1.4 (Vdd); also elsewhere on the board
+3.3VA: C16.1, C20.1, FB1.2, U4.5 (VREF+)
/Ambient Light Sensor/ALS: U4.12 (PA1); also elsewhere on the board
/Buzzer/BZ: U4.38 (PD0); also elsewhere on the board
/Clock Display/LE: U4.39 (PD1); also elsewhere on the board
/Clock Display/OE: U4.46 (PB7); also elsewhere on the board
/Clock Display/SCL: R24.2; also elsewhere on the board
/Clock Display/SDI: U4.44 (PB5); also elsewhere on the board
/Clock Display/SDO: U4.43 (PB4); also elsewhere on the board
/GPS/GPS.RX: U4.16 (PA5); also elsewhere on the board
/GPS/GPS.TP: U4.13 (PA2); also elsewhere on the board
/GPS/GPS.TX: U4.15 (PA4); also elsewhere on the board
/MCU/BT0/SWDCLK: D3.1 (K), D4.1 (K), J3.6 (JCLK/SWCLK), R19.1, SW2.1, U4.36 (PA14)
/MCU/CC1: D1.3 (K), J2.A5 (CC1); also elsewhere on the board
/MCU/CC2: D1.1 (K), J2.B5 (CC2); also elsewhere on the board
/MCU/ENC_A1: U4.30 (PC6); also elsewhere on the board
/MCU/ENC_A2: U4.28 (PA8); also elsewhere on the board
/MCU/ENC_B1: U4.31 (PC7); also elsewhere on the board
/MCU/ENC_B2: U4.29 (PA9); also elsewhere on the board
/MCU/ENC_SW1: U4.26 (PB14); also elsewhere on the board
/MCU/ENC_SW2: U4.27 (PB15); also elsewhere on the board
/MCU/FLH_CLK: U3.6 (CLK), U4.22 (PB10)
/MCU/FLH_CS: R4.1, U3.1 (~CS), U4.24 (PB12)
/MCU/FLH_MISO: U3.2 (DO/IO_{1}), U4.21 (PB2)
/MCU/FLH_MOSI: U3.5 (DI/IO_{0}), U4.23 (PB11)
/MCU/GPS_STATUS: D8.2 (A), U4.20 (PB1)
/MCU/NRST: C6.2, D9.1 (K), J3.12 (~RST), SW3.1, U4.10 (NRST)
/MCU/OSC32_IN: C19.1, U4.2 (PC14), Y2.1
/MCU/OSC32_OUT: C14.1, U4.3 (PC15), Y2.4 (3)
/MCU/OSC_IN: U4.8 (PF0), Y1.3 (OUT)
/MCU/SPI_CLK: R24.1, U4.42 (PB3)
/MCU/SWDIO: D7.1 (K), J3.4 (JTMS/SWDIO), U4.35 (PA13)
/MCU/TH.SCL: U4.18 (PA7); also elsewhere on the board
/MCU/TH.SDA: U4.17 (PA6); also elsewhere on the board
/MCU/TP_OUT: D12.2 (A), U4.14 (PA3)
/MCU/USART_RX: D5.1 (K), J3.13 (VCP_RX), U4.48 (PB9)
/MCU/USART_TX: D10.1 (K), J3.14 (VCP_TX), U4.47 (PB8)
/MCU/USB_D+: D1.5 (K), J2.A6 (D+), J2.B6 (D+), U4.34 (PA12); also elsewhere on the board
/MCU/USB_D-: D1.4 (K), J2.A7 (D-), J2.B7 (D-), U4.33 (PA11); also elsewhere on the board
GND: C3.2, C6.1, C14.2, C15.2, C16.2, C17.2, C18.2, C19.2, C20.2, D1.2 (A), D3.2 (A), D4.2 (A), D5.2 (A), D7.2 (A), D9.2 (A), D10.2 (A), J2.A1 (GND), J2.A12 (GND), J2.B1 (GND), J2.B12 (GND), J2.S1 (SHIELD), J3.5 (GND), J3.7 (GND), J3.11 (GNDDetect), R17.2, R18.2, R19.2, SW3.2, U3.4 (GND), U3.9 (EP), U4.7 (VSS), Y1.2 (GND); also elsewhere on the board
MCU_RTC: U4.4 (VBAT); also elsewhere on the board
unnamed: D8.1 (K), R17.1
unnamed: D12.1 (K), R18.1
unnamed: R5.1, U3.7 (~HOLD/~RESET/IO_{3})
unnamed: R21.1, U3.3 (~WP/IO_{2})
VBUS: J2.A4 (VBUS), J2.A9 (VBUS), J2.B4 (VBUS), J2.B9 (VBUS); also elsewhere on the board

Notes on the sheet:
USB
SPI1
TIM4
SPI Flash 32Mb/4MB
LSE Clock 32.768KHz ±20PPM
TIM17
SPI2
Decoupling
PCB Stackup SIG+GND, GND, PWR, SIG+GND to be followed
GPS Comms. Status
USART6
TIM16
GPS Status
TIM1
GPIO
RCC32
I2C2
ESD Protection
EXTI14
Default (0) - Internal Flash If Pressed duing reset (1) - BootLoader
SWD Programming Header
Time Pulse Out
SWD
MCU Internal Memory
USART3
TIM3
Reset Button
HSE TCXO Clock 10MHz ±2.5PPM
STLINK-V3MINIE Programmer to be used
EXTI15
ADC1
BOOT Mode
SPI CLK Termination Resistor
RCC
TIM15
Pulse Per Second
USB Connector
STM32G0B0CET6

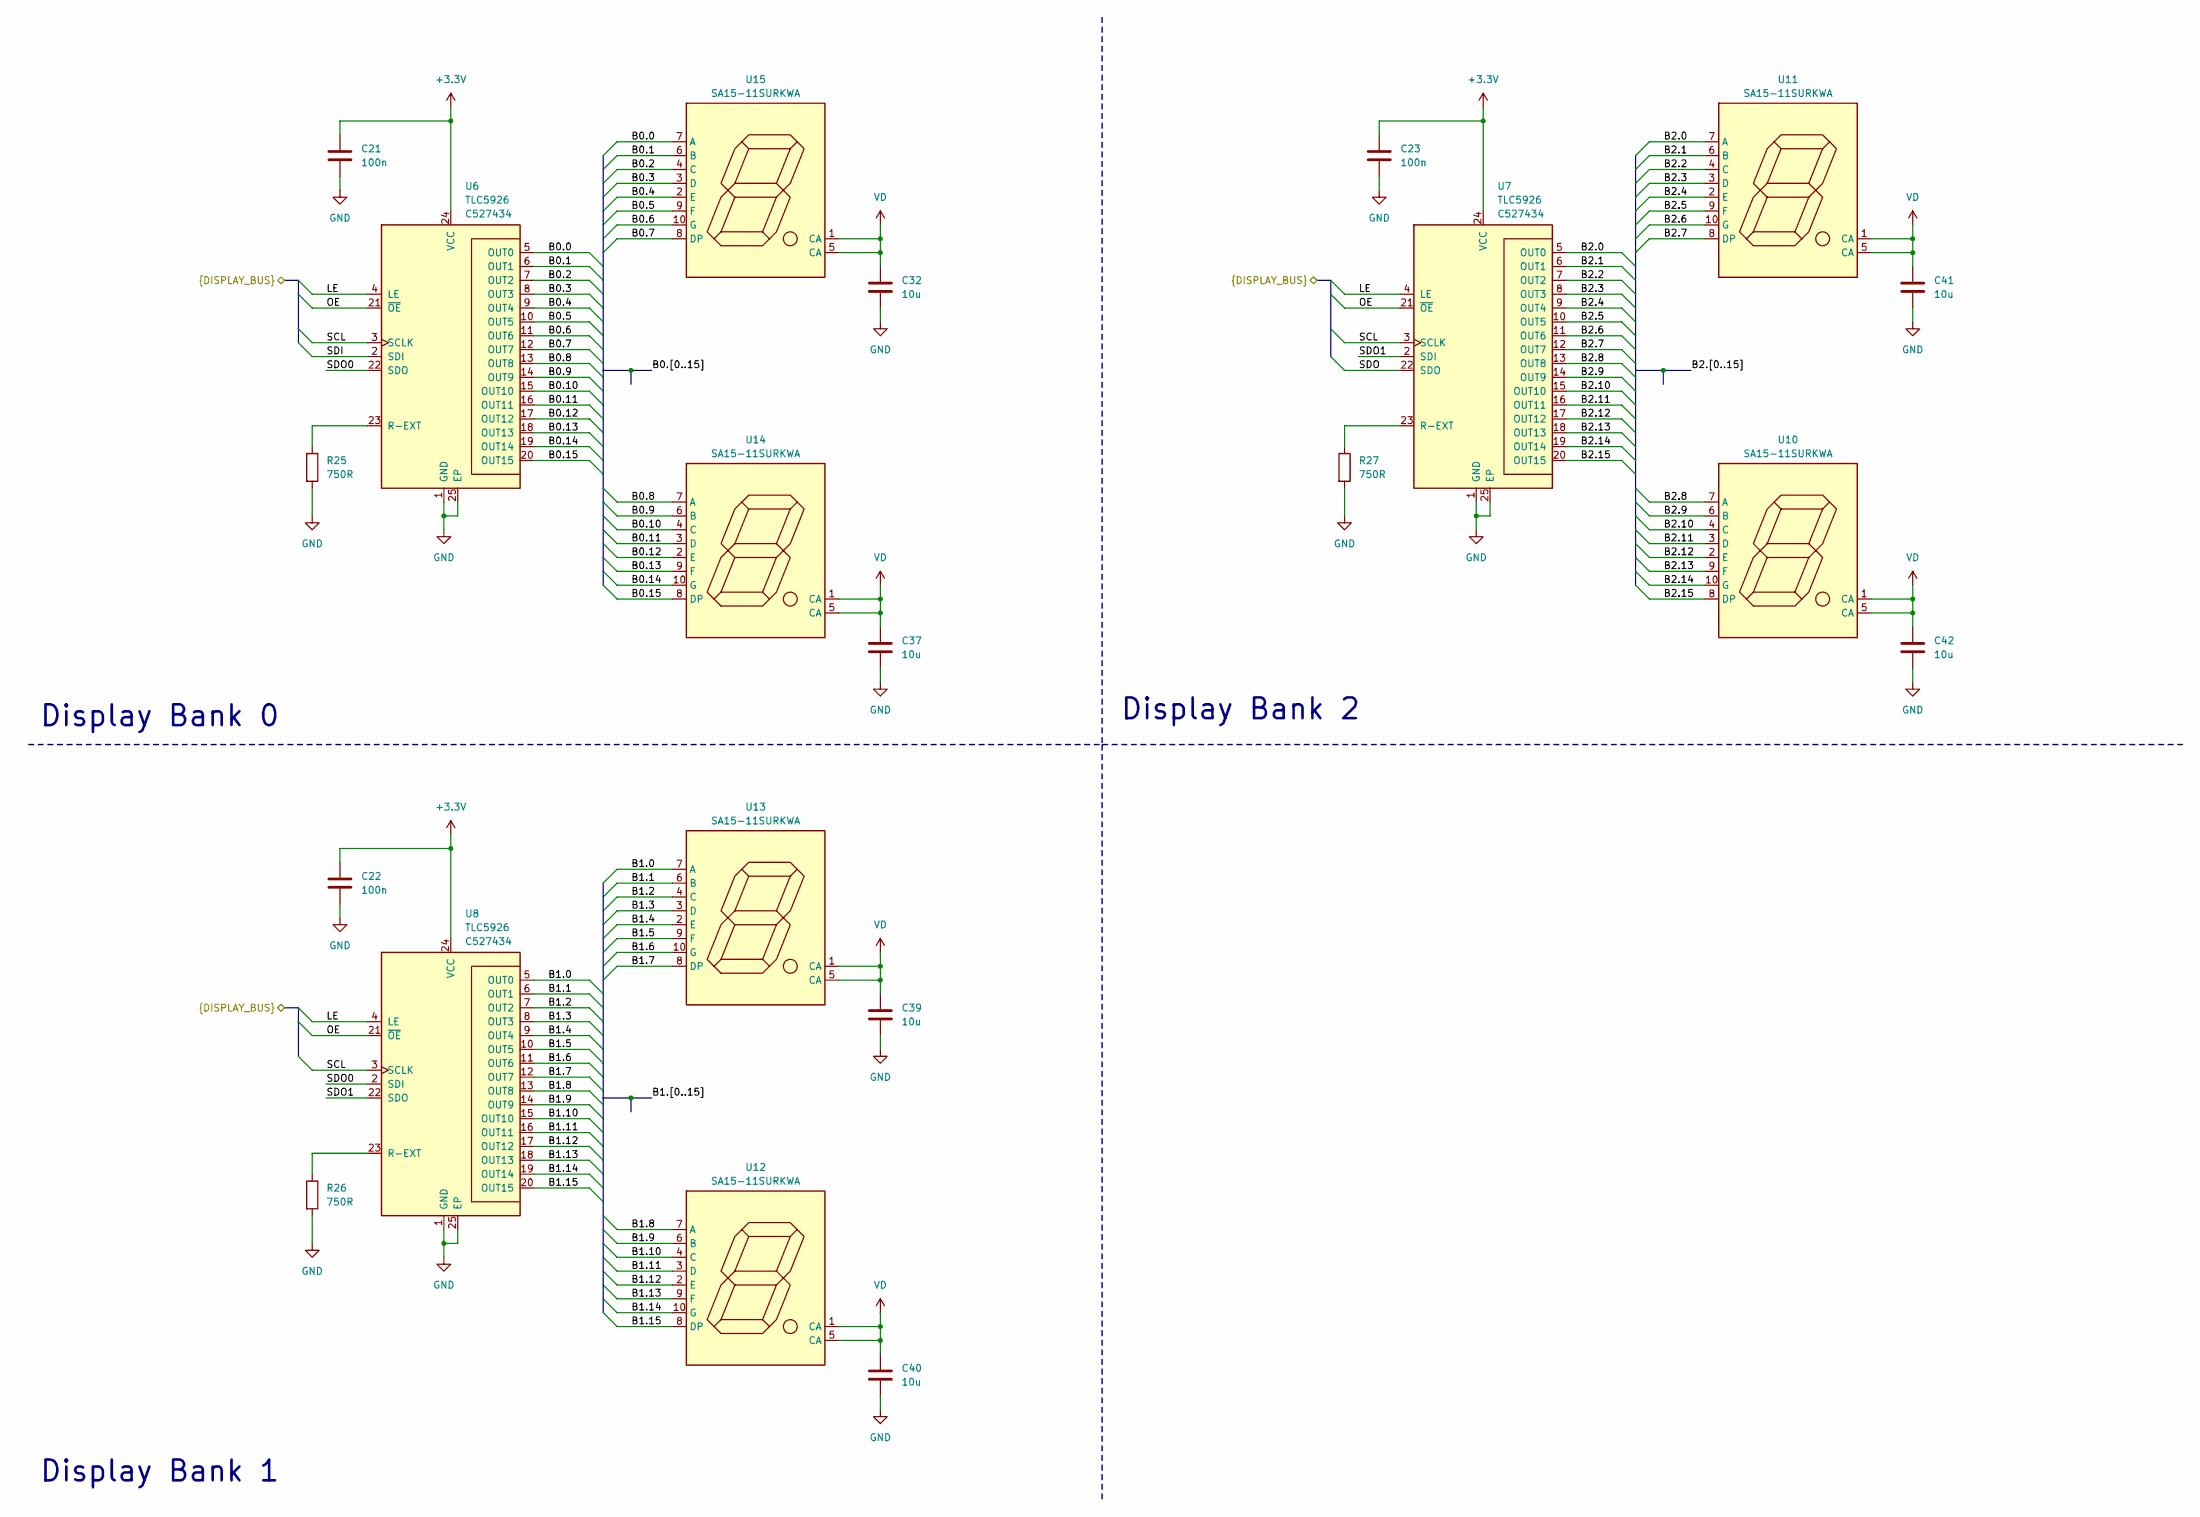
[picture p41: schematic clock_display.kicad_sch, Clock Display]

Parts:
C21, C22, C23: 100n; C_0402_1005Metric; LCSC C1525
C32, C37, C39, C40, C41, C42: 10u; C_0603_1608Metric; LCSC C86275
R25, R26, R27: 750R; R_0402_1005Metric; LCSC C137936
U6, U7, U8: TLC5926; HTSSOP-24-1EP_4.4x7.8mm_P0.65mm_EP3.2x5mm; LCSC C527434
U10, U11, U12, U13, U14, U15: SA15-11SURKWA

Connections:
+3.3V: C21.1, C22.1, C23.1, U6.24 (VCC), U7.24 (VCC), U8.24 (VCC); also elsewhere on the board
/Clock Display/B0.0: U6.5 (OUT0), U15.7 (A)
/Clock Display/B0.1: U6.6 (OUT1), U15.6 (B)
/Clock Display/B0.2: U6.7 (OUT2), U15.4 (C)
/Clock Display/B0.3: U6.8 (OUT3), U15.3 (D)
/Clock Display/B0.4: U6.9 (OUT4), U15.2 (E)
/Clock Display/B0.5: U6.10 (OUT5), U15.9 (F)
/Clock Display/B0.6: U6.11 (OUT6), U15.10 (G)
/Clock Display/B0.7: U6.12 (OUT7), U15.8 (DP)
/Clock Display/B0.8: U6.13 (OUT8), U14.7 (A)
/Clock Display/B0.9: U6.14 (OUT9), U14.6 (B)
/Clock Display/B0.10: U6.15 (OUT10), U14.4 (C)
/Clock Display/B0.11: U6.16 (OUT11), U14.3 (D)
/Clock Display/B0.12: U6.17 (OUT12), U14.2 (E)
/Clock Display/B0.13: U6.18 (OUT13), U14.9 (F)
/Clock Display/B0.14: U6.19 (OUT14), U14.10 (G)
/Clock Display/B0.15: U6.20 (OUT15), U14.8 (DP)
/Clock Display/B1.0: U8.5 (OUT0), U13.7 (A)
/Clock Display/B1.1: U8.6 (OUT1), U13.6 (B)
/Clock Display/B1.2: U8.7 (OUT2), U13.4 (C)
/Clock Display/B1.3: U8.8 (OUT3), U13.3 (D)
/Clock Display/B1.4: U8.9 (OUT4), U13.2 (E)
/Clock Display/B1.5: U8.10 (OUT5), U13.9 (F)
/Clock Display/B1.6: U8.11 (OUT6), U13.10 (G)
/Clock Display/B1.7: U8.12 (OUT7), U13.8 (DP)
/Clock Display/B1.8: U8.13 (OUT8), U12.7 (A)
/Clock Display/B1.9: U8.14 (OUT9), U12.6 (B)
/Clock Display/B1.10: U8.15 (OUT10), U12.4 (C)
/Clock Display/B1.11: U8.16 (OUT11), U12.3 (D)
/Clock Display/B1.12: U8.17 (OUT12), U12.2 (E)
/Clock Display/B1.13: U8.18 (OUT13), U12.9 (F)
/Clock Display/B1.14: U8.19 (OUT14), U12.10 (G)
/Clock Display/B1.15: U8.20 (OUT15), U12.8 (DP)
/Clock Display/B2.0: U7.5 (OUT0), U11.7 (A)
/Clock Display/B2.1: U7.6 (OUT1), U11.6 (B)
/Clock Display/B2.2: U7.7 (OUT2), U11.4 (C)
/Clock Display/B2.3: U7.8 (OUT3), U11.3 (D)
/Clock Display/B2.4: U7.9 (OUT4), U11.2 (E)
/Clock Display/B2.5: U7.10 (OUT5), U11.9 (F)
/Clock Display/B2.6: U7.11 (OUT6), U11.10 (G)
/Clock Display/B2.7: U7.12 (OUT7), U11.8 (DP)
/Clock Display/B2.8: U7.13 (OUT8), U10.7 (A)
/Clock Display/B2.9: U7.14 (OUT9), U10.6 (B)
/Clock Display/B2.10: U7.15 (OUT10), U10.4 (C)
/Clock Display/B2.11: U7.16 (OUT11), U10.3 (D)
/Clock Display/B2.12: U7.17 (OUT12), U10.2 (E)
/Clock Display/B2.13: U7.18 (OUT13), U10.9 (F)
/Clock Display/B2.14: U7.19 (OUT14), U10.10 (G)
/Clock Display/B2.15: U7.20 (OUT15), U10.8 (DP)
/Clock Display/LE: U6.4 (LE), U7.4 (LE), U8.4 (LE); also elsewhere on the board
/Clock Display/OE: U6.21 (~OE), U7.21 (~OE), U8.21 (~OE); also elsewhere on the board
/Clock Display/SCL: U6.3 (SCLK), U7.3 (SCLK), U8.3 (SCLK); also elsewhere on the board
/Clock Display/SDI: U6.2 (SDI); also elsewhere on the board
/Clock Display/SDO: U7.22 (SDO); also elsewhere on the board
/Clock Display/SDO0: U6.22 (SDO), U8.2 (SDI)
/Clock Display/SDO1: U7.2 (SDI), U8.22 (SDO)
GND: C21.2, C22.2, C23.2, C32.2, C37.2, C39.2, C40.2, C41.2, C42.2, R25.2, R26.2, R27.2, U6.1 (GND), U6.25 (EP), U7.1 (GND), U7.25 (EP), U8.1 (GND), U8.25 (EP); also elsewhere on the board
unnamed: R25.1, U6.23 (R-EXT)
unnamed: R27.1, U7.23 (R-EXT)
unnamed: R26.1, U8.23 (R-EXT)
VD: C32.1, C37.1, C39.1, C40.1, C41.1, C42.1, U10.1 (CA), U10.5 (CA), U11.1 (CA), U11.5 (CA), U12.1 (CA), U12.5 (CA), U13.1 (CA), U13.5 (CA), U14.1 (CA), U14.5 (CA), U15.1 (CA), U15.5 (CA); also elsewhere on the board

Notes on the sheet:
Display Bank 1
Display Bank 2
Display Bank 0
