TJ71PL/Precision-Clock/electronics/Precision Clock.kicad_pcb

## KiCad design electronics/Precision Clock.kicad_pcb (continued)

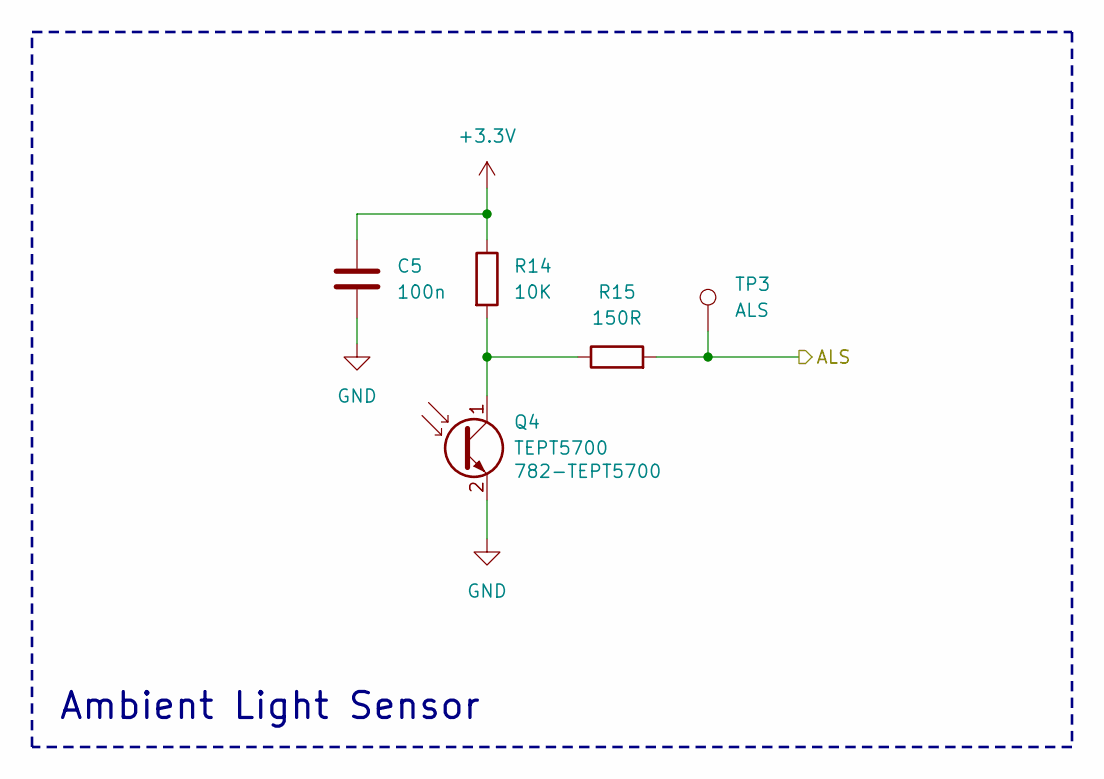
[picture p42: schematic ambient_light_sensor.kicad_sch, Ambient Light Sensor]

Parts:
C5: 100n; C_0402_1005Metric; LCSC C1525
Q4: TEPT5700; LED_D5.0mm_Clear; Mouser 782-TEPT5700
R14: 10K; R_0402_1005Metric; LCSC C60489
R15: 150R; R_0402_1005Metric; LCSC C276273
TP3: ALS; TestPoint_Pad_D1.0mm

Connections:
+3.3V: C5.1, R14.1; also elsewhere on the board
/Ambient Light Sensor/ALS: R15.2, TP3.1; also elsewhere on the board
GND: C5.2, Q4.2 (E); also elsewhere on the board
unnamed: Q4.1 (C), R14.2, R15.1

Notes on the sheet:
Ambient Light Sensor

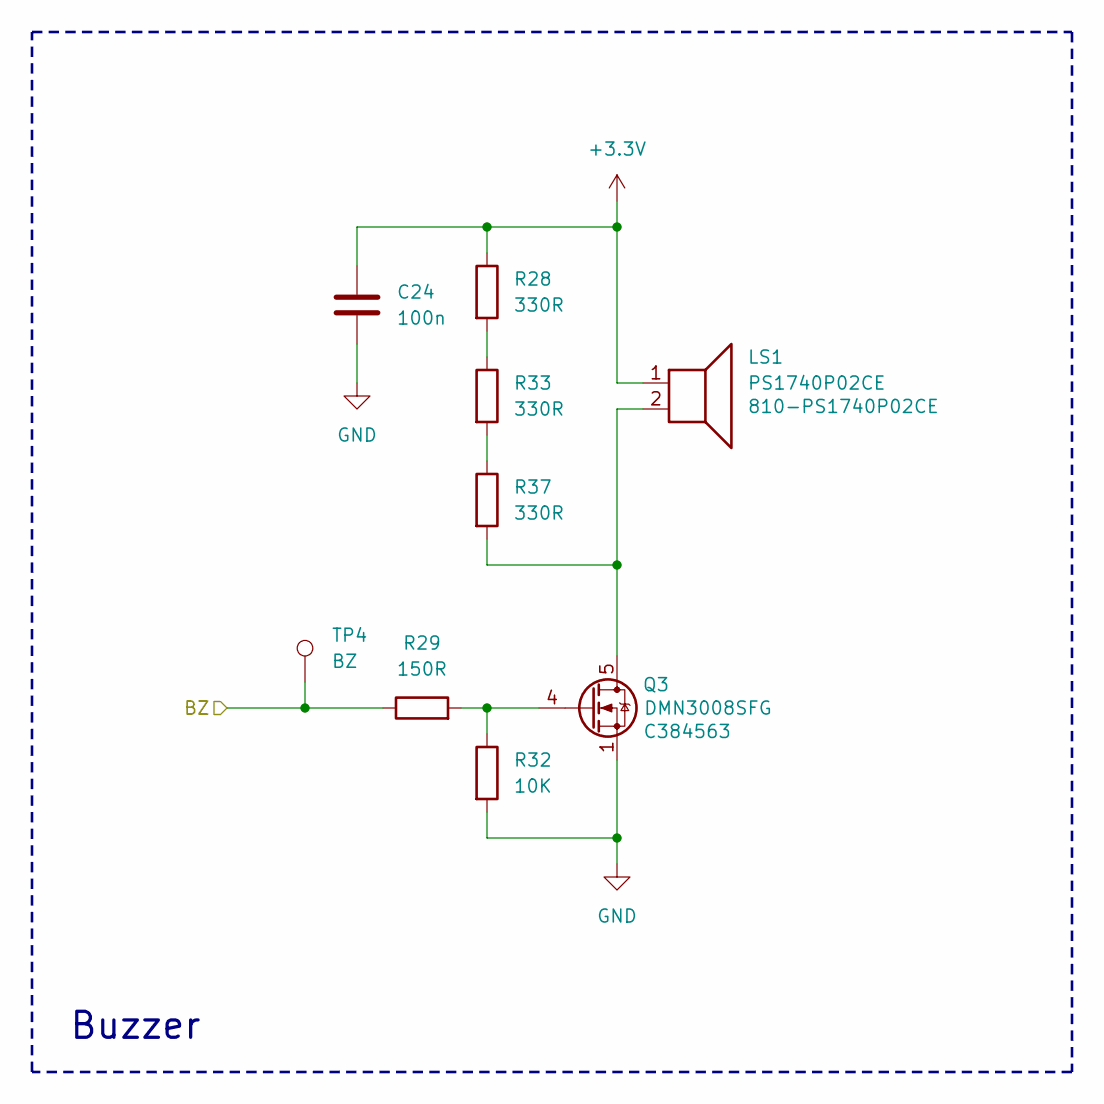
[picture p43: schematic buzzer.kicad_sch]

Parts:
C24: 100n; C_0402_1005Metric; LCSC C1525
LS1: PS1740P02CE; TDK PS1740P02CE; Mouser 810-PS1740P02CE
Q3: DMN3008SFG; Diodes_PowerDI3333-8; LCSC C384563
R28, R33, R37: 330R; R_0402_1005Metric; LCSC C276273
R29: 150R; R_0402_1005Metric; LCSC C276273
R32: 10K; R_0402_1005Metric; LCSC C60489
TP4: BZ; TestPoint_Pad_D1.0mm

Connections:
+3.3V: C24.1, LS1.1, R28.1; also elsewhere on the board
/Buzzer/BZ: R29.1, TP4.1; also elsewhere on the board
GND: C24.2, Q3.1 (S), Q3.2 (S), Q3.3 (S), R32.2; also elsewhere on the board
unnamed: LS1.2, Q3.5 (D), R37.2
unnamed: Q3.4 (G), R29.2, R32.1
unnamed: R28.2, R33.1
unnamed: R33.2, R37.1

Notes on the sheet:
Buzzer

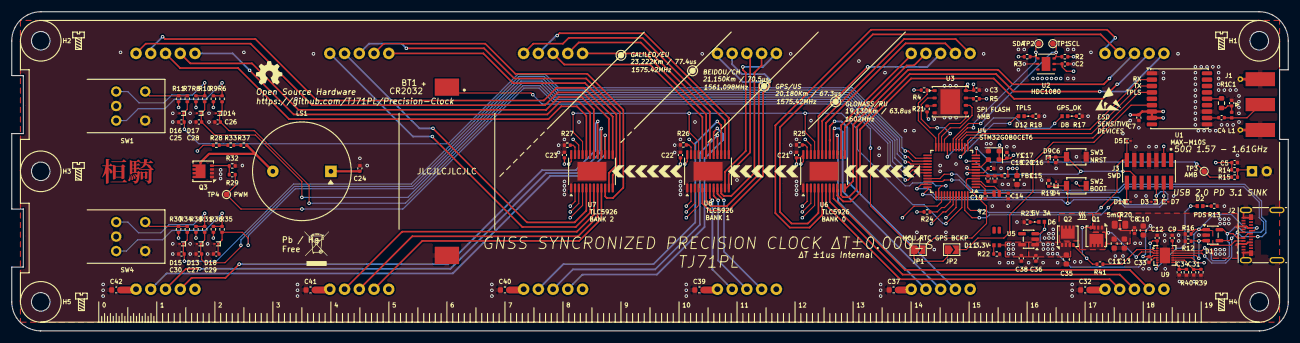
[picture p44: board Precision Clock.kicad_pcb from above]

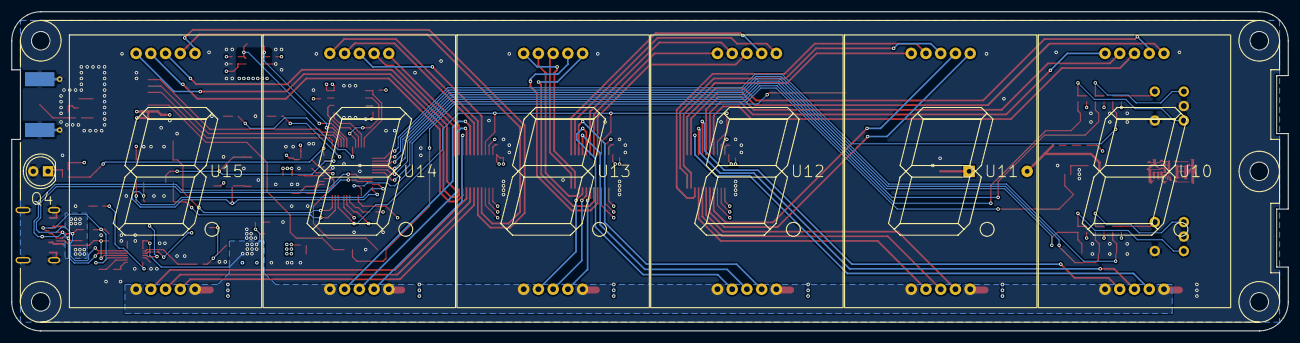
[picture p45: board Precision Clock.kicad_pcb from below]

Board: 4 copper layers, 220.0 x 55.0 mm, 144 parts (7 on the bottom side), 128 nets.
