TJ71PL/Precision-Clock/firmware/Core/Src/main.c

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
/* Includes ------------------------------------------------------------------*/
#include "main.h"
#include "cmsis_os.h"

typedef StaticTask_t osStaticThreadDef_t;
RTC_HandleTypeDef hrtc;

SPI_HandleTypeDef hspi1;
DMA_HandleTypeDef hdma_spi1_tx;

TIM_HandleTypeDef htim4;
TIM_HandleTypeDef htim16;

/* Definitions for defaultTask */
osThreadId_t defaultTaskHandle;
const osThreadAttr_t defaultTask_attributes = {
  .name = "defaultTask",
  .priority = (osPriority_t) osPriorityNormal,
  .stack_size = 512 * 4
};
/* Definitions for brightnessTask */
osThreadId_t brightnessTaskHandle;
uint32_t brightnessTaskBuffer[ 512 ];
osStaticThreadDef_t brightnessTaskControlBlock;
const osThreadAttr_t brightnessTask_attributes = {
  .name = "brightnessTask",
  .stack_mem = &brightnessTaskBuffer[0],
  .stack_size = sizeof(brightnessTaskBuffer),
  .cb_mem = &brightnessTaskControlBlock,
  .cb_size = sizeof(brightnessTaskControlBlock),
  .priority = (osPriority_t) osPriorityNormal,
};
/* Definitions for displayRefreshTask */
osThreadId_t displayRefreshTaskHandle;
uint32_t displayRefreshTaskBuffer[ 512 ];
osStaticThreadDef_t displayRefreshTaskControlBlock;
const osThreadAttr_t displayRefreshTask_attributes = {
  .name = "displayRefreshTask",
  .stack_mem = &displayRefreshTaskBuffer[0],
  .stack_size = sizeof(displayRefreshTaskBuffer),
  .cb_mem = &displayRefreshTaskControlBlock,
  .cb_size = sizeof(displayRefreshTaskControlBlock),
  .priority = (osPriority_t) osPriorityNormal,
};
void SystemClock_Config(void);
static void MX_GPIO_Init(void);
static void MX_DMA_Init(void);
static void MX_SPI1_Init(void);
static void MX_TIM4_Init(void);
static void MX_RTC_Init(void);
static void MX_TIM16_Init(void);
void StartDefaultTask(void *argument);
void startBrightnessTask(void *argument);
void startDisplayRefreshTask(void *argument);

/**
  * @brief  The application entry point.
  * @retval int
  */
int main(void)
{

  /* MCU Configuration--------------------------------------------------------*/

  /* Reset of all peripherals, Initializes the Flash interface and the Systick. */
  HAL_Init();

  /* Configure the system clock */
  SystemClock_Config();

  /* Initialize all configured peripherals */
  MX_GPIO_Init();
  MX_DMA_Init();
  MX_SPI1_Init();
  MX_TIM4_Init();
  MX_RTC_Init();
  MX_TIM16_Init();
  /* Init scheduler */
  osKernelInitialize();

  /* USER CODE BEGIN RTOS_MUTEX */
  /* add mutexes, ... */
  /* USER CODE END RTOS_MUTEX */

  /* USER CODE BEGIN RTOS_SEMAPHORES */
  /* add semaphores, ... */
  /* USER CODE END RTOS_SEMAPHORES */

  /* USER CODE BEGIN RTOS_TIMERS */
  /* start timers, add new ones, ... */
  /* USER CODE END RTOS_TIMERS */

  /* USER CODE BEGIN RTOS_QUEUES */
  /* add queues, ... */
  /* USER CODE END RTOS_QUEUES */

  /* Create the thread(s) */
  /* creation of defaultTask */
  defaultTaskHandle = osThreadNew(StartDefaultTask, NULL, &defaultTask_attributes);

  /* creation of brightnessTask */
  brightnessTaskHandle = osThreadNew(startBrightnessTask, NULL, &brightnessTask_attributes);

  /* creation of displayRefreshTask */
  displayRefreshTaskHandle = osThreadNew(startDisplayRefreshTask, NULL, &displayRefreshTask_attributes);

  /* USER CODE BEGIN RTOS_THREADS */
  /* add threads, ... */
  /* USER CODE END RTOS_THREADS */

  /* USER CODE BEGIN RTOS_EVENTS */
  /* add events, ... */
  /* USER CODE END RTOS_EVENTS */

  /* Start scheduler */
  osKernelStart();

  /* We should never get here as control is now taken by the scheduler */

  /* Infinite loop */
  /* USER CODE BEGIN WHILE */
  while (1)
  {
    /* USER CODE END WHILE */

    /* USER CODE BEGIN 3 */
  }
  /* USER CODE END 3 */
}

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
/* USER CODE BEGIN Header_StartDefaultTask */
/**
  * @brief  Function implementing the defaultTask thread.
  * @param  argument: Not used
  * @retval None
  */
/* USER CODE END Header_StartDefaultTask */
void StartDefaultTask(void *argument)
{
  /* USER CODE BEGIN 5 */
  /* Infinite loop */
  for(;;)
  {   
    osDelay(1U);  
  }
  /* USER CODE END 5 */
}

/* USER CODE BEGIN Header_startBrightnessTask */
/**
* @brief Function implementing the brightnessTask thread.
* @param argument: Not used
* @retval None
*/
/* USER CODE END Header_startBrightnessTask */
__weak void startBrightnessTask(void *argument)
{
  /* USER CODE BEGIN startBrightnessTask */
  /* Infinite loop */
  for(;;)
  {
    osDelay(1);
  }
  /* USER CODE END startBrightnessTask */
}

/* USER CODE BEGIN Header_startDisplayRefreshTask */
/**
* @brief Function implementing the displayRefreshTask thread.
* @param argument: Not used
* @retval None
*/
/* USER CODE END Header_startDisplayRefreshTask */
__weak void startDisplayRefreshTask(void *argument)
{
  /* USER CODE BEGIN startDisplayRefreshTask */
  /* Infinite loop */
  for(;;)
  {
    osDelay(1);
  }
  /* USER CODE END startDisplayRefreshTask */
}

/**
  * @brief  Period elapsed callback in non blocking mode
  * @note   This function is called  when TIM6 interrupt took place, inside
  * HAL_TIM_IRQHandler(). It makes a direct call to HAL_IncTick() to increment
  * a global variable "uwTick" used as application time base.
  * @param  htim : TIM handle
  * @retval None
  */
void HAL_TIM_PeriodElapsedCallback(TIM_HandleTypeDef *htim)
{
  if (htim->Instance == TIM6)
  {
    HAL_IncTick();
  }
}

/**
  * @brief  This function is executed in case of error occurrence.
  * @retval None
  */
void Error_Handler(void)
{
  /* USER CODE BEGIN Error_Handler_Debug */
  /* User can add his own implementation to report the HAL error return state */
  __disable_irq();
  while (1)
  {
  }
  /* USER CODE END Error_Handler_Debug */
}
#ifdef USE_FULL_ASSERT
/**
  * @brief  Reports the name of the source file and the source line number
  *         where the assert_param error has occurred.
  * @param  file: pointer to the source file name
  * @param  line: assert_param error line source number
  * @retval None
  */
void assert_failed(uint8_t *file, uint32_t line)
{
  /* USER CODE BEGIN 6 */
  /* User can add his own implementation to report the file name and line number,
     ex: printf("Wrong parameters value: file %s on line %d\r\n", file, line) */
  /* USER CODE END 6 */
}
#endif /* USE_FULL_ASSERT */
