TJ71PL/Precision-Clock/firmware/Precision-Clock.ioc

Mcu.UserName=STM32G0B0CETx
PA13.Signal=SYS_SWDIO
PA14-BOOT0.Signal=SYS_SWCLK
PB3.GPIO_Label=DISPLAY_CLK
PB3.Signal=SPI1_SCK
PB5.GPIO_Label=DISPLAY_DATA
PB5.Signal=SPI1_MOSI
PB7.GPIO_Label=DISPLAY_BRIGHTNESS
PB7.Signal=S_TIM4_CH2
PD0.GPIO_Label=BUZZER
PD0.Signal=S_TIM16_CH1
PD1.GPIO_Label=DISPLAY_UPDATE
PD1.Signal=GPIO_Output
