TJ71PL/Precision-Clock/(commit log)

2025-10-12 - addition of sensors - addition of GPS - inprogress power circuitary
    [Precision Clock.kicad_sch, display_matrix.kicad_sch, gps.kicad_sch, micro_controller.kicad_sch, power.kicad_sch, sensor.kicad_sch]
2025-10-13 Restructuring of the schematic - 4 character and LED colon addition. - Ambient light sensor addition. - Sheet pin sync.
    [4_character_matrix.kicad_sch, 5_character_matrix.kicad_sch, Precision Clock.kicad_sch, acclerometer&gyroscope.kicad_sch, ambient_light_sensor.kicad_sch, gps.kicad_sch, mcu.kicad_sch, power.kicad_sch]
2025-10-15 change in display module
    - Created new sheets
    - Reordered the sheets
    - Created the footprint for the display
    - 3D model of the display
    - MCU selection
    [4_character_matrix.kicad_sch, 5_character_matrix.kicad_sch, Precision Clock.kicad_sch, SA10-21.STEP, acclerometer&gyroscope.kicad_sch, ambient_light_sensor.kicad_sch, flash.kicad_sch, gps.kicad_sch]
2025-10-16 change in display module
    - changes the display to a common anode type display
    [4_character_matrix.kicad_sch, 5_character_matrix.kicad_sch, Precision Clock.kicad_sch, acclerometer&gyroscope.kicad_sch, ambient_light_sensor.kicad_sch, flash.kicad_sch, gps.kicad_sch, power.kicad_sch]
2025-10-17 primary MCU changes
    - added preliminary decoupling
    - added LSE
    - added flash memory
    [4_character_matrix.kicad_sch, 5_character_matrix.kicad_sch, acclerometer&gyroscope.kicad_sch, primary_mcu.kicad_sch]
2025-10-19 TXCO MCU updates - change in MCU series from L5 to U5. - primary microcontroller pin out defined. - TXCO finalized. - secondary microcontroller pin out defined. - audio amplifier added.
    [4_character_matrix.kicad_sch, 5_character_matrix.kicad_sch, Precision Clock.kicad_sch, acclerometer&gyroscope.kicad_sch, ambient_light_sensor.kicad_sch, flash.kicad_sch, gps.kicad_sch, power.kicad_sch]
2025-10-20 minor changes
    - removed the power, ambient light sensing circuits.
    - minor changes in the primary MCU pinout.
    - USB connector moved to MCU sheet.
    - ESD protection added.
    - removed the test points from the individual sheets.
    - Improved readability.
    [4_character_matrix.kicad_sch, 5_character_matrix.kicad_sch, Precision Clock.kicad_sch, acclerometer&gyroscope.kicad_sch, ambient_light_sensor.kicad_sch, gps.kicad_sch, power.kicad_sch, primary_mcu.kicad_sch]
2025-10-22 current limit resistors
    - styling changes in the schematics
    [4_character_matrix.kicad_sch, 5_character_matrix.kicad_sch, Precision Clock.kicad_sch, acclerometer&gyroscope.kicad_sch, gps.kicad_sch, power.kicad_sch, primary_mcu.kicad_sch, temperature&humidity_sensor.kicad_sch]
2025-10-22 minor changes
    - removal of colon LEDs
    - removal of test points addition of solders bridges
    - time pulse LED added
    - modification in MCU pinout
    [4_character_matrix.kicad_sch, 5_character_matrix.kicad_sch, Precision Clock.kicad_sch, acclerometer&gyroscope.kicad_sch, gps.kicad_sch, primary_mcu.kicad_sch, secondary_mcu.kicad_sch, temperature&humidity_sensor.kicad_sch]
2025-10-22 minor changes
    - annotations added
    [1054500101.stp, 4_character_matrix.kicad_sch, 5_character_matrix.kicad_sch, MAX-M10S-00B.STEP, acclerometer&gyroscope.kicad_sch, gps.kicad_sch, power.kicad_sch, primary_mcu.kicad_sch]
2025-10-23 power circuit added
    - addition of power circuit
    - added bypassing circuit
    - new formatting of the schematic
    - root schematic updated
    [4L_character_matrix.kicad_sch, 5L_character_matrix.kicad_sch, 5U_character_matrix.kicad_sch, Precision Clock.kicad_sch, acclerometer&gyroscope.kicad_sch, gps.kicad_sch, power.kicad_sch, primary_mcu.kicad_sch]
2025-10-24 addition of bus
    - cleaned up the structure of the schematic.
    - addition of the colon
    - root schematic improvements
    [5U_character_matrix.kicad_sch, HHmm_character_matrix.kicad_sch, MM-DD_character_matrix.kicad_sch, Precision Clock.kicad_pcb, Precision Clock.kicad_sch, SSsss_character_matrix.kicad_sch, YYYY-_character_matrix.kicad_sch, acclerometer&gyroscope.kicad_sch]
2025-10-24 lock removal
    [primary_mcu.kicad_sch]
2025-10-30 current limiting resistor changes
    - added colon led model, but might replace it in the future.
    - reduction in current limiting resistance.
    - removed the solder jumps in the individual circuit schematics.
    [HHmm_character_matrix.kicad_sch, MM-DD_character_matrix.kicad_sch, SSsss_character_matrix.kicad_sch, YYYY-_character_matrix.kicad_sch, acclerometer&gyroscope.kicad_sch, gps.kicad_sch, primary_mcu.kicad_sch, temperature&humidity_sensor.kicad_sch]
2025-10-31 voltage regulation changes
    - ambient light sensor addition
    - colon control
    - brightness control through regulators
    - added test points
    - MCU pinout changes
    [HHmm_character_matrix.kicad_sch, Precision Clock.kicad_sch, colon.kicad_sch, gps.kicad_sch, power.kicad_sch, primary_mcu.kicad_sch, secondary_mcu.kicad_sch, temperature&humidity_sensor.kicad_sch]
2025-10-31 buzzer addition
    - reordering
    - test point addition
    - ferrite beads on both the MCUs
    [HHmm_character_matrix.kicad_sch, MM-DD_character_matrix.kicad_sch, Precision Clock.kicad_sch, SSsss_character_matrix.kicad_sch, YYYY-_character_matrix.kicad_sch, acclerometer&gyroscope.kicad_sch, colon.kicad_sch, gps.kicad_sch]
2025-11-03 Buzzer driver added - replacement of photoresistor to a variable resistor - added button - general formatting
    [HHmm_character_matrix.kicad_sch, MM-DD_character_matrix.kicad_sch, Precision Clock.kicad_sch, SSsss_character_matrix.kicad_sch, YYYY-_character_matrix.kicad_sch, colon.kicad_sch, power.kicad_sch, primary_mcu.kicad_sch]
2025-11-04 ESD, LEDs, footprints
    - assignment of footprints
    - ESD protection
    - User buttons
    - addition of test points
    - BOM consolidation of resistors
    - general reordering of the schematic
    [4L_character_matrix.kicad_sch, 4_character_matrix.kicad_sch, 5L_character_matrix.kicad_sch, 5U_character_matrix.kicad_sch, 5_character_matrix.kicad_sch, HHmm_character_matrix.kicad_sch, MM-DD_character_matrix.kicad_sch, Precision Clock.kicad_sch]
2025-11-05 verification
    - sensor schematic verification
    - change in the value of current limiting resistor
    - disconnected unused buffer pins
    - labeling or peripherals used in primary MCU
    - additional user button
    - DRC corrections
    [HHmm_character_matrix.kicad_sch, MM-DD_character_matrix.kicad_sch, Precision Clock.kicad_sch, SSsss_character_matrix.kicad_sch, YYYY-_character_matrix.kicad_sch, acclerometer&gyroscope.kicad_sch, colon.kicad_sch, gps.kicad_sch]
2025-11-07 semi final verification
    - change in display type to common cathode
    - verification of the schematic
    - addition of footprints
    - further minor changes
    [HHmm_character_matrix.kicad_sch, MM-DD_character_matrix.kicad_sch, Precision Clock.kicad_pcb, Precision Clock.kicad_sch, SSsss_character_matrix.kicad_sch, YYYY-_character_matrix.kicad_sch, acclerometer&gyroscope.kicad_sch, colon.kicad_sch]
2025-11-10 PCB routing
    - JLCPCB constraints added
    - removal of multiple test points
    - change of footprints
    - change of THT LEDs
    - rough position of all the major components
    - PCB routing started
    [HHmm_character_matrix.kicad_sch, MM-DD_character_matrix.kicad_sch, Precision Clock.kicad_pcb, Precision Clock.kicad_sch, SSsss_character_matrix.kicad_sch, YYYY-_character_matrix.kicad_sch, acclerometer&gyroscope.kicad_sch, colon.kicad_sch]
2025-11-11 PCB routing
    - addition of 3D models
    - addition of docs
    - reduction of the size of passives
    - increase in size of traces
    [1054500101.stp, 3352T-1-103LF.STEP, 450301014042 (rev1).stp, HHmm_character_matrix.kicad_sch, MM-DD_character_matrix.kicad_sch, PS1440P02BT_TDK.step, Precision Clock.kicad_pcb, SSsss_character_matrix.kicad_sch]
2025-11-12 PCB routing
    [Precision Clock.kicad_pcb]
2025-11-13 PCB routing restarted
    - removal of all previous traces and vias
    - placement of most of the parts
    - priority towards high speed lines like USB and USART
    [1060.STEP, Precision Clock.kicad_pcb, power.kicad_sch, primary_mcu.kicad_sch, secondary_mcu.kicad_sch]
2025-11-14 PCB routing
    - high priority nets connected
    - primary MCU nets connected
    - reposition of footprints
    [Precision Clock.kicad_pcb]
2025-11-17 PCB routing
    - secondary MCU routing started
    - primary MCU routing completed
    [Precision Clock.kicad_pcb]
2025-11-18 PCB routing
    - low power trace routing completion
    [Precision Clock.kicad_pcb, secondary_mcu.kicad_sch]
2025-11-21 Major overhaul required
    - Secondary MCU External clock to be included
    - possible removal of colon drivers
    - priority towards the end product over schematic
    - high speed signals to be tuned like QSPI and USB
    [Precision Clock.kicad_pcb, primary_mcu.kicad_sch, secondary_mcu.kicad_sch]
2025-11-25 Primary MCU rerouting
    [HHmm_character_matrix.kicad_sch, MM-DD_character_matrix.kicad_sch, Precision Clock.kicad_pcb, SSsss_character_matrix.kicad_sch, YYYY-_character_matrix.kicad_sch, acclerometer&gyroscope.kicad_sch, colon.kicad_sch, gps.kicad_sch]
2025-11-26 Secondary MCU rerouting
    [HHmm_character_matrix.kicad_sch, MM-DD_character_matrix.kicad_sch, Precision Clock.kicad_pcb, Precision Clock.kicad_sch, SSsss_character_matrix.kicad_sch, YYYY-_character_matrix.kicad_sch, acclerometer&gyroscope.kicad_sch, colon.kicad_sch]
2025-11-27 Secondary MCU rerouting
    - Bank 2 completion
    - OSC net completion
    [Precision Clock.kicad_pcb, secondary_mcu.kicad_sch]
2025-11-28 Secondary MCU complete
    [Precision Clock.kicad_pcb, primary_mcu.kicad_sch, secondary_mcu.kicad_sch]
2025-12-01 Position correction
    [Precision Clock.kicad_pcb]
2025-12-02 High power routing
    [Precision Clock.kicad_pcb]
2025-12-23 Schematic changes
    - signal for dots are removed.
    - power supply upgraded to buck converters.
    - individually addressable Colon LEDs.
    - second millisecond dot separator signal is not connected.
    - buzzer can now be connected to PWM or DAC outputs.
    [HHmmSSsss_character_matrix.kicad_sch, HHmm_character_matrix.kicad_sch, MM-DD_character_matrix.kicad_sch, Precision Clock.kicad_pcb, Precision Clock.kicad_sch, SSsss_character_matrix.kicad_sch, YYYY-MM-DD_character_matrix.kicad_sch, YYYY-_character_matrix.kicad_sch]
2025-12-24 Power stage changes
    - removal of potentiometer
    - addition of rotary encoder
    - addition of ambient light sensor
    - addition of unity gain differential amplifier.
    - reording of the schematic.
    [HHmmSSsss_character_matrix.kicad_sch, Precision Clock.kicad_sch, acclerometer&gyroscope.kicad_sch, power.kicad_sch, primary_mcu.kicad_sch, secondary_mcu.kicad_sch, temperature&humidity_sensor.kicad_sch]
2026-01-23 updated power
    [Precision Clock.kicad_sch, YYYY-MM-DD_character_matrix.kicad_sch, acclerometer&gyroscope.kicad_sch, clock_display.kicad_sch, colon.kicad_sch, gps.kicad_sch, power.kicad_sch, primary_mcu.kicad_sch]
2026-01-26 Pin out completion
    [Accelerometer & Gyroscope.kicad_sch, Buzzer.kicad_sch, Precision Clock.kicad_sch, Primary MCU.kicad_sch, Temperature & Humidity Sensor.kicad_sch, User Inputs.kicad_sch, ambient light sensor.kicad_sch, gps.kicad_sch]
2026-01-26 Removal of Colon LEDs
    [Accelerometer & Gyroscope.kicad_sch, Clock Display.kicad_sch, MCU.kicad_sch, Precision Clock.kicad_pcb, Precision Clock.kicad_sch, SA15-11EWA.stp, Temperature & Humidity Sensor.kicad_sch, User Inputs.kicad_sch]
2026-01-26 buzzer and ambient light sensor added
    [Buzzer.kicad_sch, Clock Display.kicad_sch, MCU.kicad_sch, Precision Clock.kicad_pcb, ambient light sensor.kicad_sch, power.kicad_sch]
2026-01-27 removal of sensors
    [Clock Display.kicad_sch, MCU.kicad_sch, Magnetic Sensor.kicad_sch, Precision Clock.kicad_sch, Temperature & Humidity Sensor.kicad_sch, gps.kicad_sch, power.kicad_sch]
2026-01-27 addition of BME690
    [Accelerometer & Gyroscope.kicad_sch, Buzzer.kicad_sch, Clock Display.kicad_sch, MCU.kicad_sch, Magnetic Sensor.kicad_sch, PS1440P02BT_TDK.step, Precision Clock.kicad_pcb, Precision Clock.kicad_sch]
2026-01-28 Changed BOOT0 switch
    [MCU.kicad_sch, Precision Clock.kicad_pcb, power.kicad_sch]
2026-01-29 Removed One Rotary Encoder
    [MCU.kicad_sch, Precision Clock.kicad_pcb, Precision Clock.kicad_sch, User Inputs.kicad_sch, ambient light sensor.kicad_sch, gps.kicad_sch, power.kicad_sch]
2026-01-29 Verification
    - changed the piezo electric speaker.
    - verified some schematics
    [Buzzer.kicad_sch, Clock Display.kicad_sch, MCU.kicad_sch, PS1740P02CE.stp, Precision Clock.kicad_pcb, Precision Clock.kicad_sch, Temperature, Humidity & Gas Sensor.kicad_sch, User Inputs.kicad_sch]
2026-02-02 Power subsystem updated
    [Buzzer.kicad_sch, Clock Display.kicad_sch, MCU.kicad_sch, Precision Clock.kicad_pcb, Precision Clock.kicad_sch, ambient light sensor.kicad_sch, gps.kicad_sch, power.kicad_sch]
2026-02-05 display driver update
    [Buzzer.kicad_sch, Display.kicad_sch, LEDs.kicad_sch, MCU.kicad_sch, Precision Clock.kicad_pcb, Precision Clock.kicad_sch, Temperature, Humidity & Gas Sensor.kicad_sch, User Inputs.kicad_sch]
2026-02-06 Display Driver Completion
    [Buzzer.kicad_sch, Clock Display.kicad_sch, Display.kicad_sch, LEDs.kicad_sch, MCU.kicad_sch, Precision Clock.kicad_pcb, Precision Clock.kicad_sch, Temperature, Humidity & Gas Sensor.kicad_sch]
2026-02-09 Footprints added
    [Buzzer.kicad_sch, Clock Display.kicad_sch, MCU.kicad_sch, Precision Clock.kicad_pcb, Temperature, Humidity & Gas Sensor.kicad_sch, User Inputs.kicad_sch, ambient light sensor.kicad_sch, gps.kicad_sch]
2026-02-24 Major Changes
    [AP33771C.stp, Buzzer.kicad_sch, Clock Display.kicad_sch, MCU.kicad_sch, PEC09-2320F-S0015.step, PinHeader_2x07_P1.27mm_Vertical_SMD.step, Precision Clock.kicad_pcb, Precision Clock.kicad_sch]
2026-02-26 Encoder placement
    [Clock Display.kicad_sch, MCU.kicad_sch, Precision Clock.kicad_pcb, Temperature, Humidity & Gas Sensor.kicad_sch, User Inputs.kicad_sch, ambient light sensor.kicad_sch, gps.kicad_sch, power.kicad_sch]
2026-02-26 TJ71PL added
    [Precision Clock.kicad_pcb]
2026-02-27 Minor changes
    [Buzzer.kicad_sch, Clock Display.kicad_sch, MCU.kicad_sch, Precision Clock.kicad_pcb, Temperature, Humidity & Gas Sensor.kicad_sch, User Inputs.kicad_sch, ambient light sensor.kicad_sch, gps.kicad_sch]
2026-02-28 Production files preparation
    [Buzzer.kicad_sch, Clock Display.kicad_sch, MCU.kicad_sch, Precision Clock.kicad_pcb, SA15-11EWA.step, Temperature, Humidity & Gas Sensor.kicad_sch, User Inputs.kicad_sch, ambient light sensor.kicad_sch]
2026-03-08 In Production
    [BOM-Precision Clock.csv, Buzzer.kicad_sch, Clock Display.kicad_sch, MCU.kicad_sch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]
2026-03-10 Footprint Fix Production Paused
    [CPL-Precision Clock.csv, Precision Clock-CuBottom.gbr, Precision Clock-CuIn1.gbr, Precision Clock-CuIn2.gbr, Precision Clock-CuTop.gbr, Precision Clock-EdgeCuts.gbr, Precision Clock-MaskBottom.gbr, Precision Clock-MaskTop.gbr]
2026-03-11 Push Button Replacement
    [BOM-Precision Clock.csv, Buzzer.kicad_sch, Clock Display.kicad_sch, HDC1080DMBR.STEP, MCU.kicad_sch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]
2026-03-12 MCU replacement
    [Buzzer.kicad_sch, Clock Display.kicad_sch, MCU.kicad_sch, Precision Clock.kicad_pcb, Precision Clock.kicad_sch, Temperature & Humidity Sensor.kicad_sch, User Inputs.kicad_sch, ambient light sensor.kicad_sch]
2026-03-14 Production Ready v2
    [BOM-Precision Clock.csv, Power.kicad_sch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]
2026-03-15 firmware init
    [1054500101.stp, 1060.STEP, 3352T-1-103LF.STEP, 450301014042 (rev1).stp, AP33771C.stp, BOM-Precision Clock.csv, HDC1080DMBR.STEP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]
2026-06-09 Firmware Dev Init
    [Precision Clock.kicad_pcb, Precision Clock.kicad_sch, ambient_light_sensor.kicad_sch, buzzer.kicad_sch, clock_display.kicad_sch, gps.kicad_sch, mcu.kicad_sch, power.kicad_sch]
